RensBloom/LuxSenz/graphs section 2/lcd_shutter_and_reflective_surface_diagram.pptx

TRANSMITTER

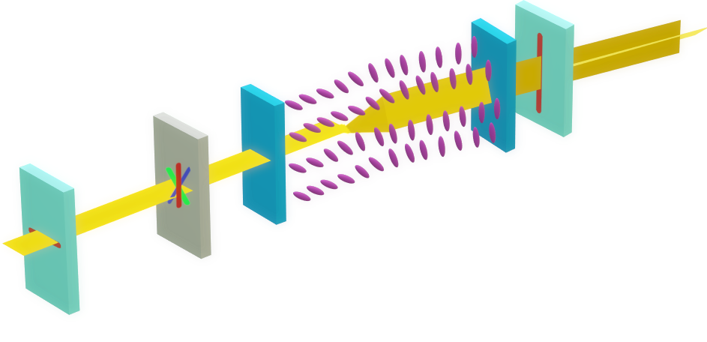
[picture p7: figure]

Polarizer films (with orthogonal axes)

Unpolarized light

RECEIVER

Phone

Liquid crystal layer

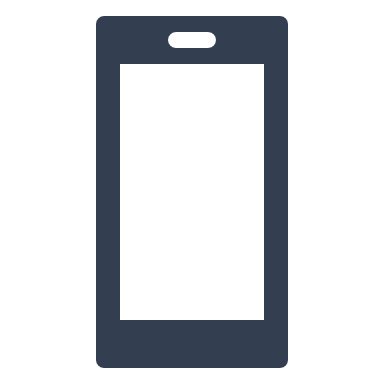
[picture p8: figure]
Smart Phone

Glass substrate

Dispersor

## Slide 2

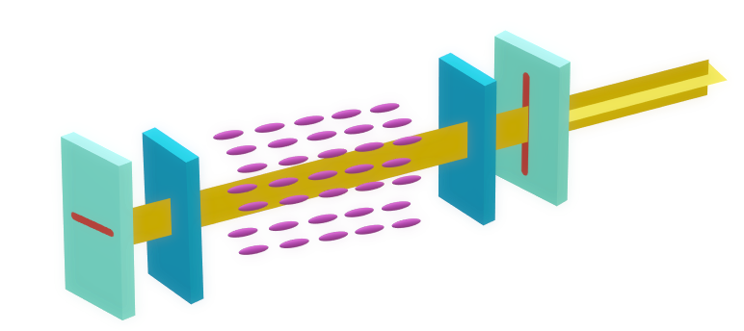
[picture p9: figure]

Voltage applied

Unpolarized light

Liquid crystal layer

Glass substrate

Polarizer films (vertical axis)

Polarizer films (horizontal axis)

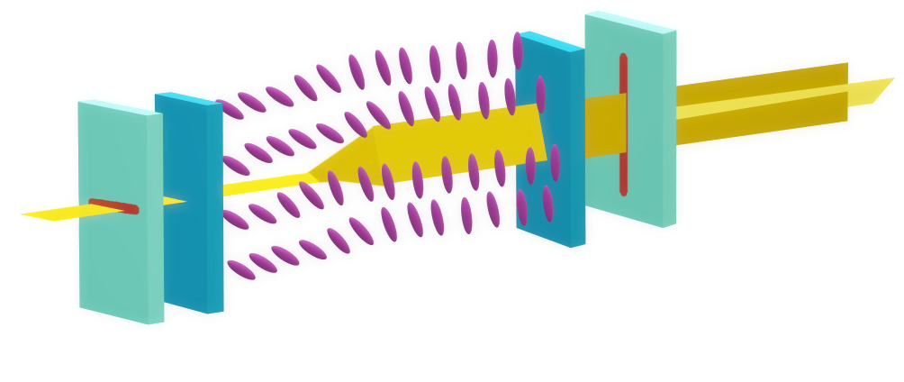
[picture p10: figure]

No voltage applied

Unpolarized light

Liquid crystal layer

## Slide 3

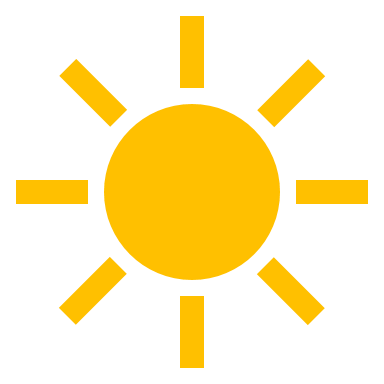
[picture p11: figure]
Sun
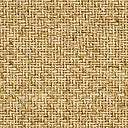
[picture p12: figure]

Mirror

Retroreflector

Diffuser
