RensBloom/LuxSenz/presentations/ES Group meeting.pptx

Light communication for sensors

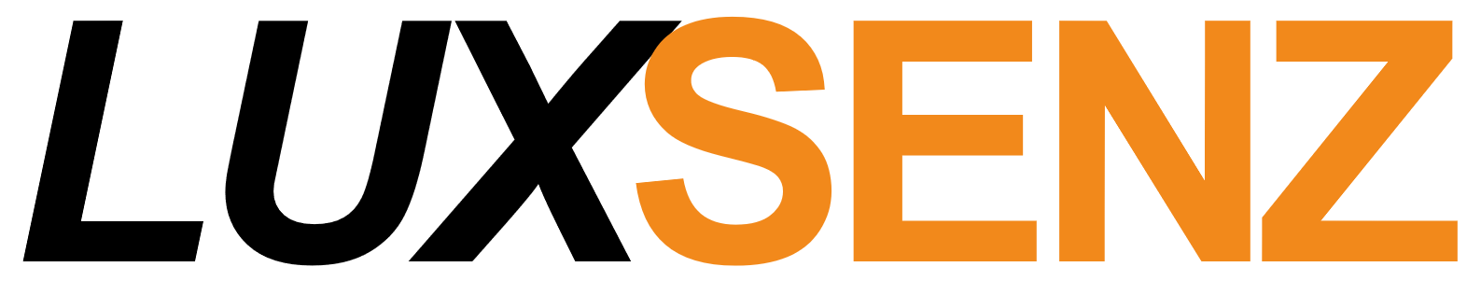
[picture p13: figure]

## The future: smart cities

Sensors everywhere

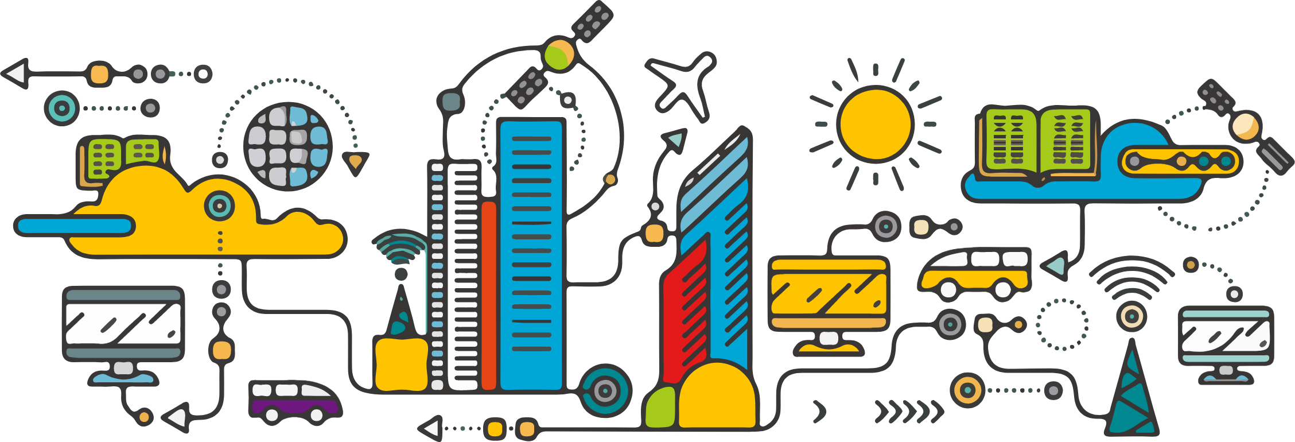
[picture p14: figure]

Notes: Let’s take a look into the future: We see smart cities in which connectivity of devices grows.
There are sensors everywhere and that is a good thing. Sensors can help monitoring the quality of life within the city. You can think of sensors to measure air pollution, traffic flows and temperature changes.

## The future: smart cities

Challenge: communication

Notes: Challenge: communication
Communication is expensive: In 2013 we were already using more energy to move bits and bytes on the Internet, than by flying airplanes over the whole world. Wireless communication like 4G, Bluetooth or WiFi always consumes a lot of energy. Adding more of those signals is a waste of energy, and present signals can degrade the communication quality and speed.

## The future: smart cities

LiFi: use the lights

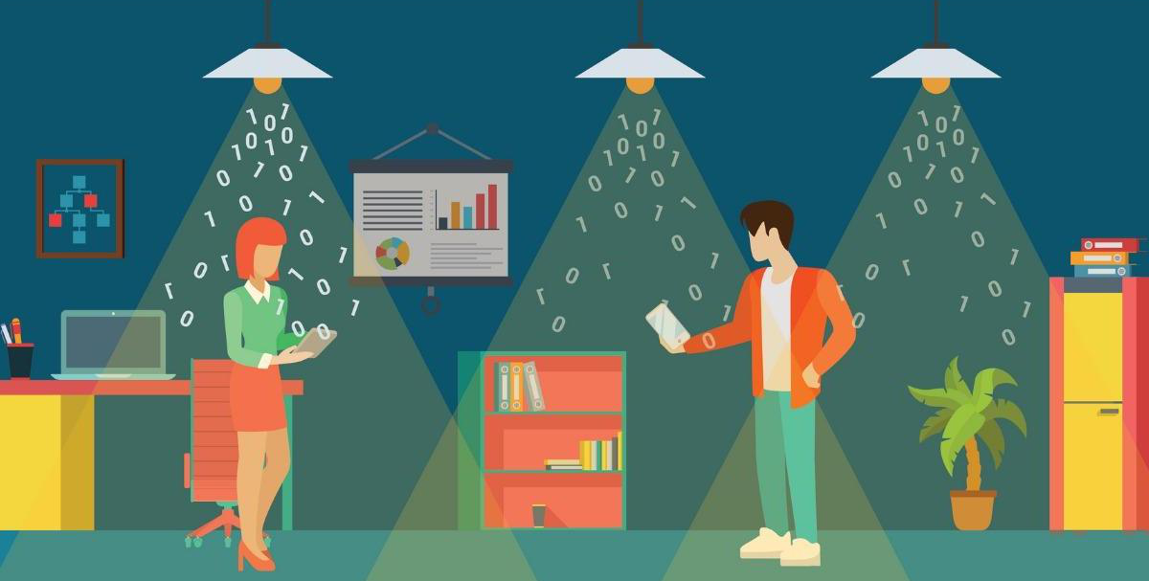
[picture p15: figure]
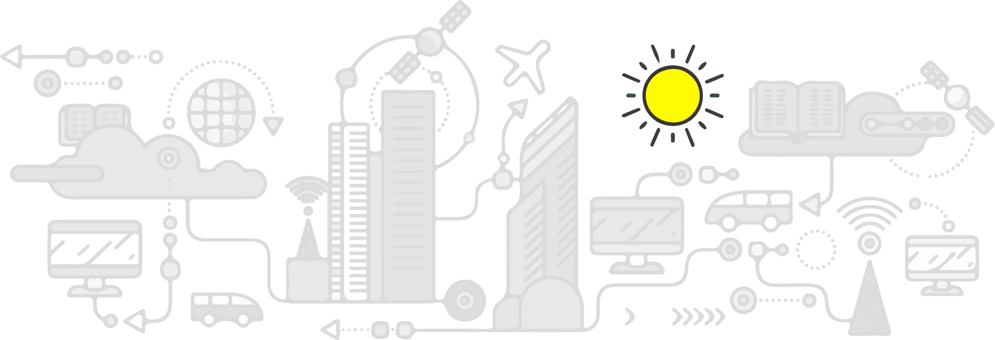
[picture p16: figure]

Notes: One solution (if the challenge is a problem), would be LiFi.
I don’t think we always want to turn on lights at daytime to enable WiFi. That would be a larger waste of energy than using WiFi.

## The future: smart cities

LuxSenz focuses on sunlight

Notes: In this city, we focus on sunlight.
The sun is an abundant resources that provides energy.
We use the energy of the sun for communication.
Natural soure of energy
We do not only use solar panels, but make light the motor/carrier of the wireless communication.
We do not need radio waves

## The future: smart cities

Reflecting the light = data

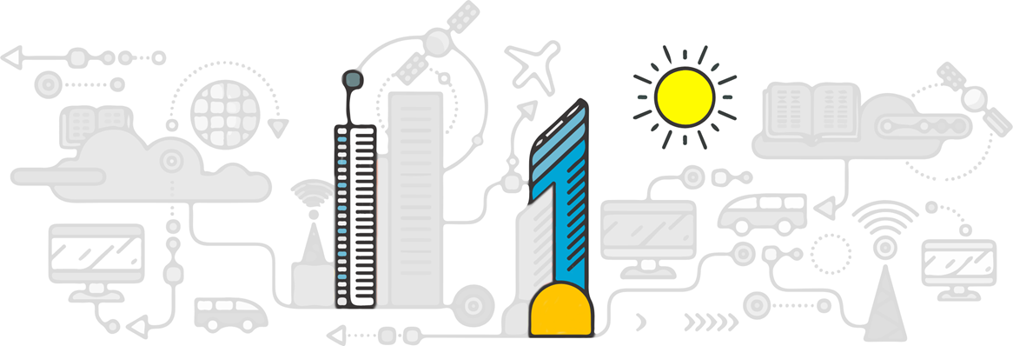
[picture p17: figure]

Notes: How does it work?
Every object reflects light. If I would were a blue or a white shirt, that already makes a difference.
By controlling reflections digitally, we can transmit sensor data directly.
Data from sensors on different buildings can be collected with minimal energy: only the collection point then needs internet.

## Demo time!

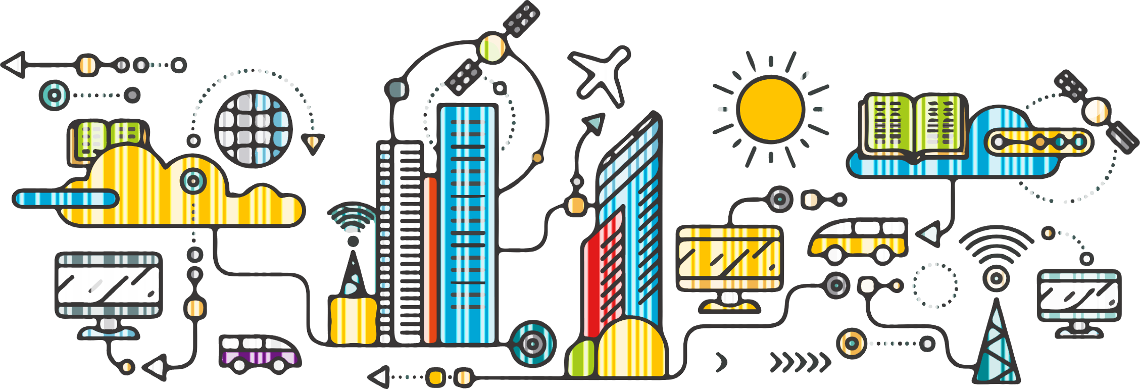
[picture p18: figure]

Notes: A vision could be to have everything in a city communication through visible light reflections.
The idea to use LuxSenz is hard to sell, but the technology works.

## The present: connecting cities

Automation is going on

Notes: Let’s go back to the city as it is now. More and more processes are automated by installing sensors and that is definitely an improvement.
We should look for urban challenges that need a bit of innovation to be solved: as a university we can offer innovative projects.

## The present: defect street lights

Usually everything works fine…

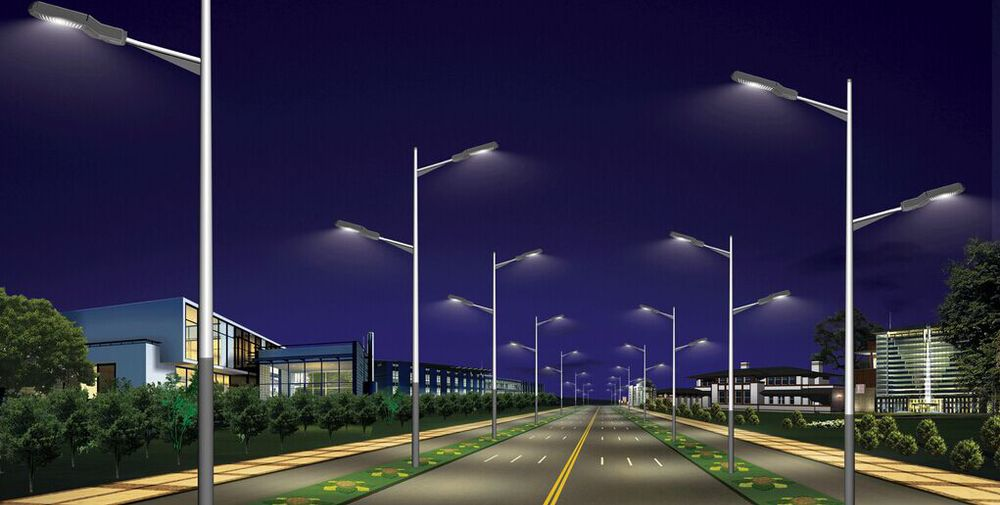
[picture p19: figure]

Notes: Let’s go back to the city as it is now

## The present: defect street lights

How would you detect a defect light?

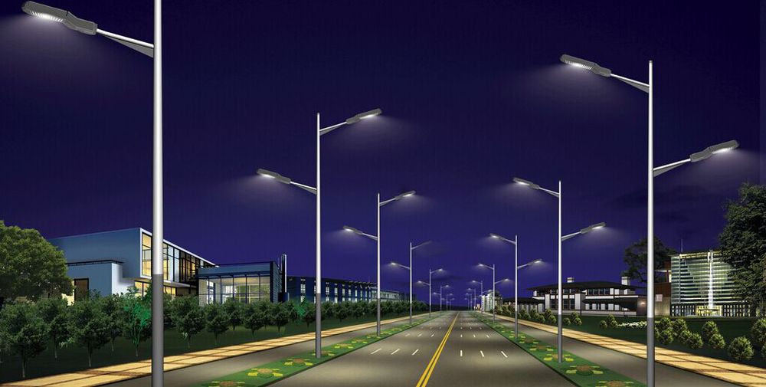
[picture p20: figure]

Notes: Let’s go back to the city as it is now
