RensBloom/LuxSenz/presentations/LuxSenz-short.pptx

Light communication for sensors


## The future: smart cities

Sensors everywhere


Notes: Let’s take a look into the future: We see smart cities in which connectivity of devices grows.
There are sensors everywhere and that is a good thing. Sensors can help monitoring the quality of life within the city. You can think of sensors to measure air pollution, traffic flows and temperature changes.

## The future: smart cities

Challenge: communication

Notes: Challenge: communication
Communication is expensive: In 2013 we were already using more energy to move bits and bytes on the Internet, than by flying airplanes over the whole world. Wireless communication like 4G, Bluetooth or WiFi always consumes a lot of energy. Adding more of those signals is a waste of energy, and present signals can degrade the communication quality and speed.

## The future: smart cities

Focus on sunlight


Notes: In this city, we focus on sunlight.
The sun is an abundant resources that provides energy.
We use the energy of the sun for communication.
Natural source of energy
We do not only use solar panels, but make light the motor/carrier of the wireless communication.
We do not need radio waves

## The future: smart cities

Works with clouds, and indoors

Notes: Using mirrors, one could build a heliograph to transmit data: similar to what armies already were using a few ages ago.
LuxSenz is designed more general, such that it works with any common source of ambient light, even with diffuse light.
It works with clouds, or indoors with LED, fluorescent and other lights.

## The future: smart cities

Reflecting the light = data


Notes: How does it work?
Every object reflects light. If I would were a blue or a white shirt, that already makes a difference.
By controlling reflections digitally, we can transmit sensor data directly.
Data from sensors on different buildings can be collected with minimal energy: only the collection point then needs internet.

## The future: smart cities

FSK signal around 600 Hz: invisible

Notes: The encoding scheme on the surface is FSK. The amount of reflected light changes a few hundred times per second such that the human eye doesn’t perceive any flickering.

## Our vision? LuxSenz everywhere


Notes: Make it ready for a large connected city, such that the sunlight is not wasted.
