RensBloom/LuxSenz/documentation/img_misc/expansion_3d_1.png

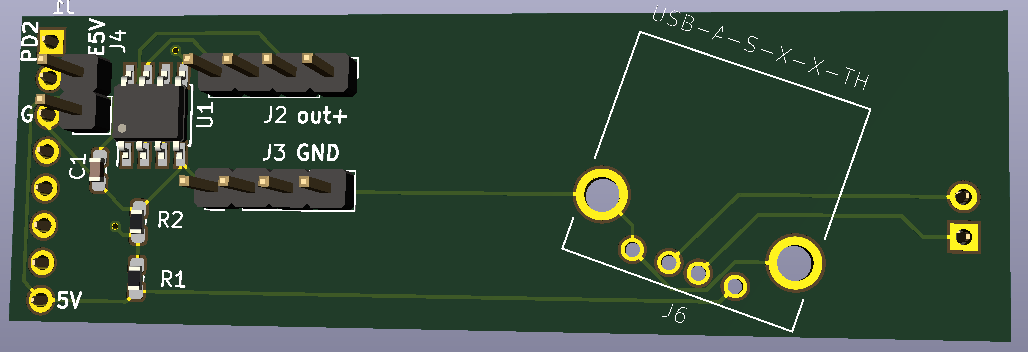
documentation/img_misc/expansion_3d_1.png
