RensBloom/LuxSenz/documentation/img_misc/expansion_3d_2.png

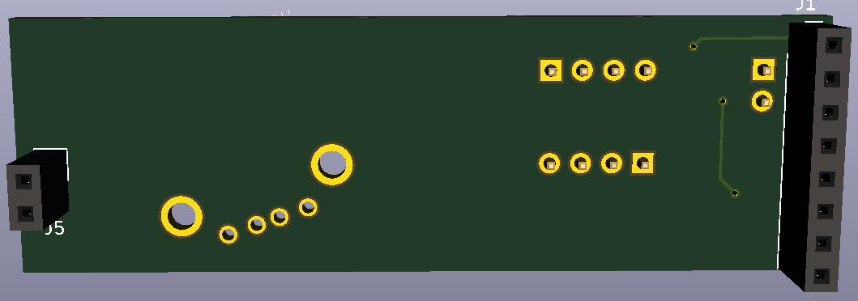
documentation/img_misc/expansion_3d_2.png
