RensBloom/LuxSenz/documentation/img_misc/headers.png

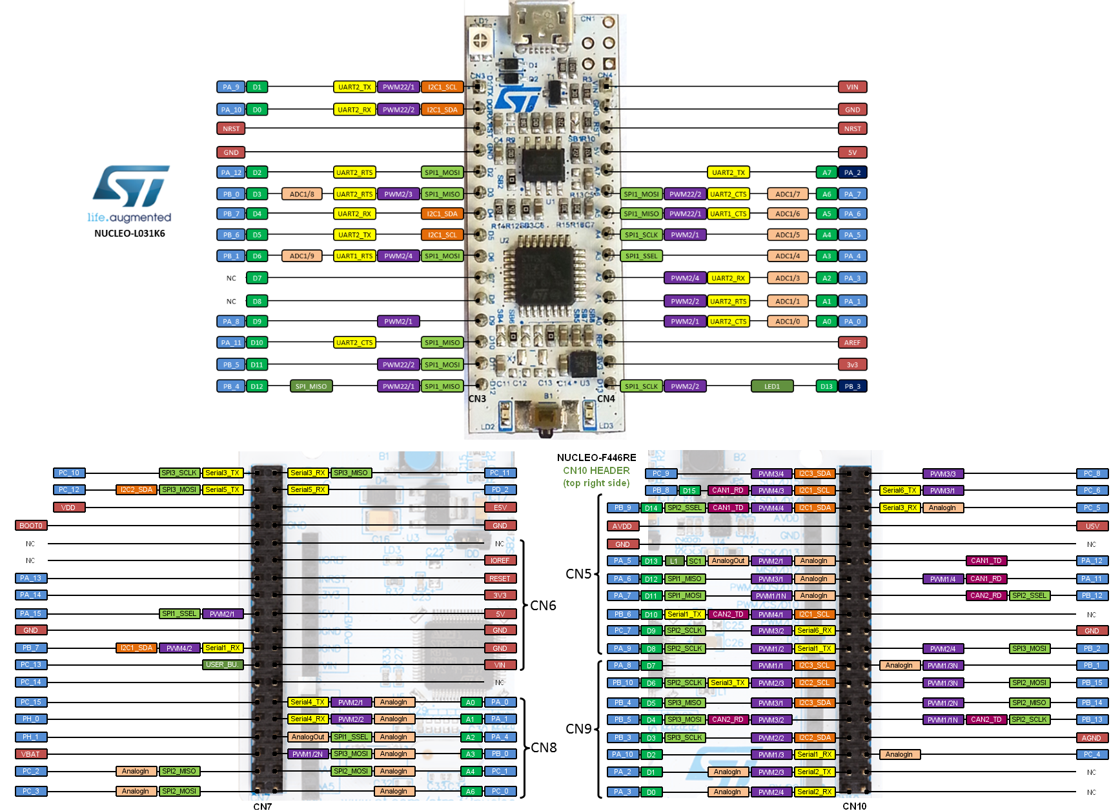
documentation/img_misc/headers.png
