RensBloom/LuxSenz/images/IMG_9840small.jpg

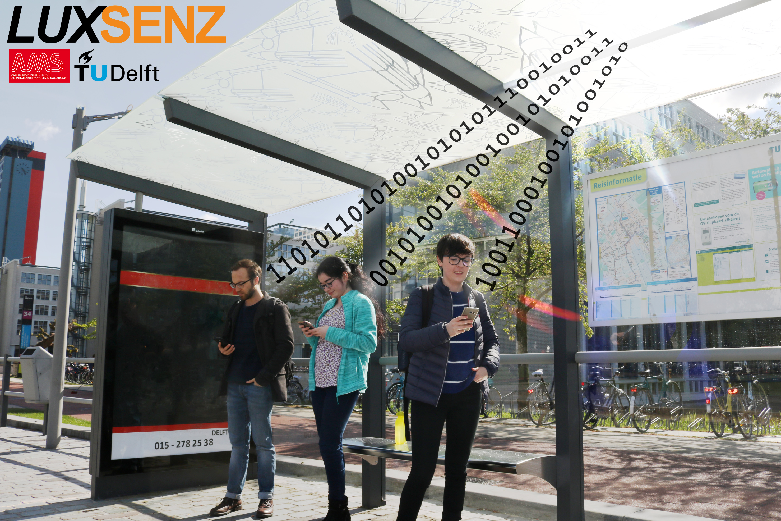
images/IMG_9840small.jpg
