RensBloom/LuxSenz/images/receiver.jpg

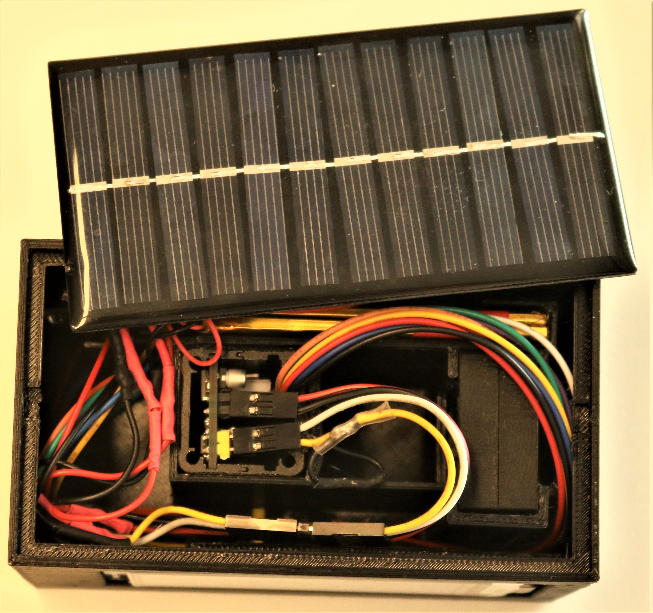
images/receiver.jpg
