RensBloom/LuxSenz/images/receiver_small3.jpg

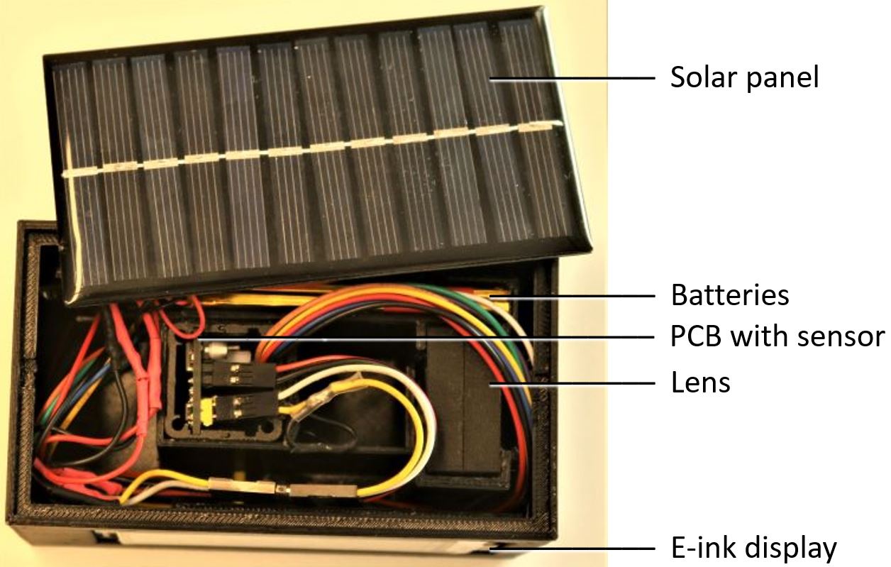
images/receiver_small3.jpg
