RensBloom/LuxSenz/images/transmitter.jpg

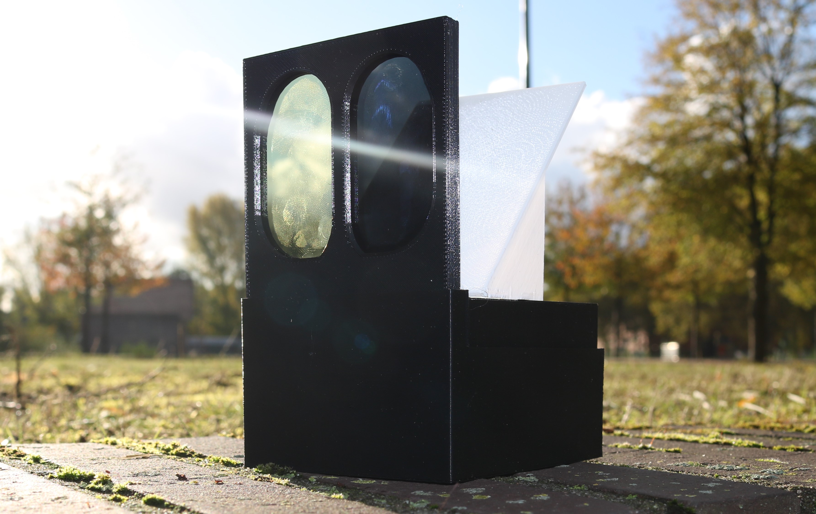
images/transmitter.jpg
