RensBloom/LuxSenz/miscellanous/luxsenz_inventory.xlsx

Sheet: Products received in Dec 2017
Serial number | Product name | Link | Dimensions | Quantity
1 | Liquid crystal light valve (LCD shutter) | https://www.sossolutions.nl/3330-liquid-crystal-light-valve-lcd-controllable-black-out-panel | 96.5 x 38 x 2mm | 15
2 | Circular TN shutter | email liquid crystal technologies for order | 110mm diameter | 2
3 | Self adhesive smart glass (5w/m2) | email oypdlc for order | a4 | 2
4 | Relay circuit | https://nl.aliexpress.com/item/Free-Shipping-1-Channel-H-L-Level-Triger-Optocoupler-Relay-New-Module-for-Arduino-12V-Smart/32658267283.html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 |  | 6
5 | Mirror | http://www.ikea.com/nl/nl/catalog/products/50366921/?query=LOTS+Mirror | 30cm*30cm | 1
6 | Solar panel 5v | https://nl.aliexpress.com/item/Solar-Cell-5V-1-25W-Portable-Module-DIY-110x69mm-Small-Solar-Panel-for-Cellular-Phone-Charger/32820292775.html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 |  | 10
7 | Solar panel 12v | https://nl.aliexpress.com/item/Universal-12V-1-5W-Standard-Epoxy-Solar-Panels-Mini-Solar-Cells-Polycrystalline-Silicon-DIY-Battery-Power/32757562057.html |  | 4
8 | Lithium battery charging module | https://nl.aliexpress.com/item/5PCS-Micro-USB-5V-1A-18650-Lithium-Battery-Charger-Board-With-Protection-Module/32666559864.html | 5 pieces per pack | 4
9 | Li ion battery 3.7v 500mah | https://nl.aliexpress.com/item/10-pcs-3-7V-500mAh-rechargeable-lipo-battery-601452-li-polymer-lithium-for-MP3-bluetooth-speaker/32819786913.html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 | pack of 10 | 1
10 | Power booster | https://nl.aliexpress.com/item/5-pcs-DC-DC-Converter-Step-Up-Boost-Module-0-9-5V-T0-5V-600MA-USB/1879190967.html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 | 5 pieces per pack | 4
11 | Logic converter | https://www.sossolutions.nl/757-4-channel-i2c-safe-bi-directional-logic-level-converter |  | 5
12 | Photo transistor | http://nl.farnell.com/osram/sfh206k/photodiode/dp/1212741?ost=sfh206k&iscrfnonsku=false |  | 30
13 | Digital light sensor | https://www.sossolutions.nl/439-adafruit-tsl2561-digital-luminosityluxlight-sensor-breakout |  | 2
14 | LCD 16x2 | https://nl.aliexpress.com/item/Free-Shipping-1PCS-LCD1602-1602-module-Green-screen-16x2-Character-LCD-Display-Module-HD44780-Controller-blue/32292861233.html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 | 2 arrived | 4

Sheet: Inventory dec 2018
 | Paid by AMS |  |  |  | Paid by TU Delft
Sr. no. | Product name | Quantity | The components are inclusive of what is installed the current LuxSenz setup | Sr. no. | Product name | Quantity
1 | Rectangular shutter | 15 | Not used in current LuxSenz setup | 51 | Nucleo F446RE MCU dev boards | 3
2 | Video shutter | 24 |  | 52 | Nucleo 031K6 dev boards | 2
3 | 3D glasses (2 shutters per glass) | 10
4 | Circular shutter | 1
5 | Pi cell | 50
6 | Smart glass | 2
7 | Luxsenz transmitter F446RE extension PCB | 4
8 | Luxsenz receiver PCB | 40 | Many of these are not yet assembled
9 | Luxsenz transceiver PCB | 40 | Many of these are not yet assembled
10 | Luxmeter | 2
11 | Solar panel 6V (110*60 mm) | 4
12 | E ink display | 2
13 | LiPo battery 3.7V | 3
14 | ST LINK V2 STM32 programmer | 0 | Nucleo development boards can also be used as a programmer. Otherwise, buy one of these on Ebay (less than $3)
15 | 25mm diameter lens | 5
16 | Other lenses | 3
17 | TP4056 Li battery charger | 7
18 | MPL115A2 sensor (pressure)
19 | Si7021 (temp/humidity)
20 | Transmitter 3D print | 4
21 | Receiver 3D print | 4
22 | Transceiver 3D print | 1
23 | STM32LO31K6T6 LQFP-32 | 1
24 | Logic converter (CJMCU 0108) | 5
25 | CD4049UBE inverter IC | 2
26 | CD4070BE XOR IC | 1
27 | LM324AN OPAMP IC | 1
28 | Mirror 30*30 cm | 4
30 | DC to DC converter (step up booster to 5 V) | 20
31 | optocoupler relay (for smart glass) | 6
32 | LCD 16X2 | 2
33 | Mirrors square (for video shutter) | 4
34 | Mirrors rect (for rect shutter) | 3
35 | Mirrors circ (for circ shutter) | 2
36 | 8-pin JST-XH Cables | 6
37 | 4-pin Dupont jumber wires | >5
38 | STM32F103C8T6 dev boards | 76
39 | HC SR04 ultrasone sensor | 2
