RensBloom/LuxSenz/miscellanous/LuxSenz performance.xlsx

Sheet: Sheet1
 |  |  |  |  |  |  |  | Battery voltage | Light intensity (lx) |  |  |  | Transmitter | BER |  | Notes
FSK f1 | FSK f2 | Duty Cycle (%) | Balanced? | Transmitter | Receiver | Location | Surface (cm2) | Transmitter | Transmitter | Receiver | Distance (cm) | Angle (deg) | offset (cm) | error | total
560 | 640 | 50 | no | L031K6 + 2x 3D glass shutter | Purple/white | Social Data Lab | 26 | 4.4 | 190 | 78 | 177 | 0 |  | 1 | 10000 | Light intensity without LEDs turned on: 18lx, 25lx
560 | 640 | 50 | no | L031K6 + 2x 3D glass shutter | Purple/white | Social Data Lab | 26 | 4.4 | 190 | 100 | 245 | 0 |  | 0 | 10000
560 | 640 | 50 | no | L031K6 + 2x 3D glass shutter | Purple/white | Social Data Lab | 26 | 4.4 | 190 | 80 | 308 | 0 |  | 0 | 10000
560 | 640 | 50 | no | L031K6 + 2x 3D glass shutter | Purple/white | Social Data Lab | 26 | 4.4 | 200 | 80 | 614 | 0 |  | 0 | 10000
560 | 640 | 50 | no | L031K6 + 2x 3D glass shutter | Purple/white | Social Data Lab | 26 | 4.4 | 220 | 45 | 727 | 0 |  | 5 | 10000
560 | 640 | 50 | no | L031K6 + 2x 3D glass shutter | Purple/white | Social Data Lab | 26 | 4.4 | 220 | 50 | 750 | 0 |  | 8 | 10000
560 | 640 | 50 | no | L031K6 + 2x 3D glass shutter | Purple/white | Social Data Lab | 26 | 4.4 | 200 | 45 | 775 | 0 |  | 11 | 10000
560 | 640 | 50 | no | L031K6 + 2x 3D glass shutter | Purple/white | Social Data Lab | 26 | 4.4 | 240 | 50 | 800 | 0 | 0 | 46 | 10000
560 | 640 | 50 | no | L031K6 + 2x 3D glass shutter | Purple/white | Social Data Lab | 26 | 4.4 | 240 | 45 | 800 | 0 | 1 | 36 | 10000
560 | 640 | 50 | no | L031K6 + 2x 3D glass shutter | Purple/white | Social Data Lab | 26 | 4.4 | 240 | 45 | 800 | 0 | 2 | 34 | 10000
560 | 640 | 50 | no | L031K6 + 2x 3D glass shutter | Purple/white | Social Data Lab | 26 | 4.4 | 220 | 50 | 800 | 0 | 3 | 30 | 10000
560 | 640 | 50 | no | L031K6 + 2x 3D glass shutter | Purple/white | Social Data Lab | 26 | 4.4 | 220 | 50 | 800 | 0 | 4 | 61 | 10000
560 | 640 | 50 | no | L031K6 + 2x 3D glass shutter | Purple/white | Social Data Lab | 26 | 4.4 | 220 | 50 | 800 | 0 | 5 | 36 | 5000
560 | 640 | 50 | no | L031K6 + 2x 3D glass shutter | Purple/white | Social Data Lab | 26 | 4.4 | 220 | 50 | 800 | 0 | -0.5 | 102 | 7000
560 | 640 | 50 | no | L031K6 + 2x 3D glass shutter | Purple/white | Social Data Lab | 26 | 4.4 | 220 | 50 | 800 | 0 | 0.5 | 96 | 10000
560 | 640 | 50 | no | L031K6 + 2x 3D glass shutter | Purple/white | Social Data Lab | 26 | 4.4 | 220 | 50 | 800 | -20 | 0 | 60 | 720
560 | 640 | 50 | no | L031K6 + 2x 3D glass shutter | Purple/white | Social Data Lab | 26 | 4.4 | 220 | 50 | 800 | -10 | 0 | 101 | 1200
560 | 640 | 50 | no | L031K6 + 2x 3D glass shutter | Purple/white | Social Data Lab | 26 | 4.4 | 220 | 50 | 800 | -5 | 0 | 50 | 2000
560 | 640 | 50 | no | L031K6 + 2x 3D glass shutter | Purple/white | Social Data Lab | 26 | 4.4 | 220 | 50 | 800 | 0 | 0 | 60 | 3100
560 | 640 | 50 | no | L031K6 + 2x 3D glass shutter | Purple/white | Social Data Lab | 26 | 4.4 | 220 | 50 | 800 | 5 | 0 | 72 | 2800
560 | 640 | 50 | no | L031K6 + 2x 3D glass shutter | Purple/white | Social Data Lab | 26 | 4.4 | 220 | 50 | 800 | 10 | 0 | 48 | 1072
560 | 640 | 50 | no | L031K6 + 2x 3D glass shutter | Purple/white | Social Data Lab | 26 | 4.4 | 290 | 120 | 615 | 0 | 0 | 2 | 10000
560 | 640 | 50 | no | L031K6 + 2x 3D glass shutter | Purple/white | Social Data Lab | 26 | 4.4 | ? | ? | 615 | 15 | 0 | 1 | 10000
560 | 640 | 50 | no | L031K6 + 2x 3D glass shutter | Purple/white | Social Data Lab | 26 | 4.4 | ? | ? | 615 | 30 | 0 | 12 | 10000
560 | 640 | 50 | no | L031K6 + 2x 3D glass shutter | Purple/white | Social Data Lab | 26 | 4.4 | ? | ? | 615 | 45 | 0 | 72 | 592
560 | 640 | 50 | no | L031K6 + 2x 3D glass shutter | Purple/white | Social Data Lab | 26 | 4.4 | 200 | 100 | 615 | 37.5 | 0 | 46 | 10000
560 | 640 | 50 | no | L031K6 + 2x 3D glass shutter | Yellow/Black | Social Data Lab | 26 | 4.35 | 260 | 120 | 615 | 0 | 0 | 20 | 10000
560 | 640 | 50 | no | L031K6 + 2x 3D glass shutter | Yellow/Black | Social Data Lab | 26 | 5.03 | 380 | 190 | 615 | 0 | 0 | 5 | 10000
560 | 640 | 50 | no | L031K6 + 2x 3D glass shutter | Yellow/Black | Social Data Lab | 26 | 5.03 | 410-470 | 190-200 | 615 |  |  | 9 | 10000
560 | 640 | 50 | no | L031K6 + 2x 3D glass shutter | Yellow/Black | Social Data Lab | 26 | 5.03 | 130-150 | 80 | 615 |  |  | 40 | 5000
560 | 640 | 50 | no | L031K6 + 2x 3D glass shutter | Yellow/Black | Social Data Lab | 26 | 5.03 | 100 | 60 | 615 |  |  | 37 | 3700
560 | 640 | 50 | no | L031K6 + 2x 3D glass shutter | Yellow/Black | Social Data Lab | 26 | 5.03 | 50 | 70 | 615 |  |  | 15 | 400
560 | 640 | 50 | no | L031K6 + 2x 3D glass shutter | Yellow/Black | Social Data Lab | 26 | 5.03 | 70 | 90 | 615 |  |  | 18 | 1500
560 | 640 | 50 | no | L031K6 + 2x 3D glass shutter | Yellow/Black | Social Data Lab | 26 | 5.03 | 260 | 140 | 616 |  |  | 8 | 10000
560 | 640 | 50 | no | L031K6 + 2x 3D glass shutter | Yellow/Black | Outdoors (Cloudy) | 26 | 5 | 33000 | sat (+- 60000) | 1750 |  |  | 23 | 10000
560 | 640 | 50 | no | L031K6 + 2x 3D glass shutter | Yellow/Black | Outdoors (Cloudy) | 26 | 4.35 | 33000 | sat (+- 60000) | 1750 |  |  | 2 | 10000
560 | 640 | 50 | no | L031K6 + 2x 3D glass shutter | Yellow/Black | Outdoors (Cloudy) | 26 | 4.35 | 37000 |  | 2400 |  |  | 41 | 10000
560 | 640 | 50 | no | L031K6 + 2x 3D glass shutter | Yellow/Black | Outdoors (Cloudy) | 26
560 | 640 | 50 | no | L031K6 + 2x 3D glass shutter | Yellow/Black | Outdoors (Cloudy) | 26
560 | 640 | 50 | no | L031K6 + 2x 3D glass shutter | Yellow/Black | Outdoors (Cloudy) | 26
560 | 640 | 50 | no | L031K6 + 2x 3D glass shutter | Yellow/Black | Outdoors (Cloudy) | 26

Sheet: Sheet 2
 |  |  |  |  |  |  | Transmitter |  |  |  |  |  | Battery voltage |  | Sideways | Light intensity (lx) |  | Light intensity (lx) |  | BER |  |  | PLR |  |  | amplitude |  |  | nothing |  | amp |  | coverage
id | set | FSK f1 | FSK f2 | Duty Cycle (%) | Balanced? | Receiver | MCU | Surface | f | Location | Location | Surface (cm2) | Transmitter | Distance (m) | offset (cm) | Receiver | Transmitter | Receiver | Transmitter | error | total | BER | error | total | PLR | S1 | S2 | P3 | S1 | S1/lx_t | S1 delta | S1d/lx_t | X (cm) | Y (cm) | X (m) | Y (m) | lux sets | BSR | PSR
1 | 1 | 560 | 640 | 50 | yes | Yellow/Black | L031K6 | 2x 3D glass shutter | 560/640 | Basement | 1 | 26 | 4.4 | 1 | 0 | 200 | 300 | 200 | 300 | 78 | 10000 | 0.007800 | 10 | 35 | 0.286 |  |  |  |  |  |  |  |  |  |  |  | 1 | 0.9922 | 0.7142857143
2 | 1 | 560 | 640 | 50 | yes | Yellow/Black | L031K6 | 2x 3D glass shutter | 560/640 | Basement | 1 | 26 | 4.4 | 2 | 0 | 200 | 210 | 200 | 210 | 41 | 480 | 0.085417 | inf | 0 | 1.000 |  |  |  |  |  |  |  |  |  |  |  | 1 | 0.9145833333 | 0
3 | 1 | 560 | 640 | 50 | yes | Yellow/Black | L031K6 | 2x 3D glass shutter | 560/640 | Basement | 1 | 26 | 4.4 | 3 | 0 | 200 | 400 | 200 | 400 |  |  |  |  |  |  |  |  |  |  |  |  |  |  |  |  |  | 2
4 | 2 | 560 | 640 | 50 | yes | Yellow/Black | L031K6 | 2x 3D glass shutter | 560/640 | Outdoors | 2 | 26 | 4.4 | 5 | 0 | 6000 | 6000 | 6000 | 6000 | 9 | 10000 | 0.000900 | 3 | 36 | 0.083 | 4094 | 4094 | 16000 |  | 0.6823333333 |  |  |  |  |  |  | 3 | 0.9991 | 0.9166666667
5 | 2 | 560 | 640 | 50 | yes | Yellow/Black | L031K6 | 2x 3D glass shutter | 560/640 | Outdoors | 2 | 26 | 4.4 | 10 | 0 | 5700 | 11000 | 5700 | 11000 | 33 | 10000 | 0.003300 | 9 | 35 | 0.257 | 3700 | 3800 | 12300 |  | 0.3363636364 |  |  |  |  |  |  | 4 | 0.9967 | 0.7428571429
6 | 2 | 560 | 640 | 50 | yes | Yellow/Black | L031K6 | 2x 3D glass shutter | 560/640 | Outdoors | 2 | 26 | 4.4 | 15 | 0 | 6000 | 10000 | 6000 | 10000 | 1 | 10000 | 0.000100 | 0 | 37 | 0.000 | 2000 | 2200 | 5500 |  | 0.2 |  |  |  |  |  |  | 4 | 0.9999 | 1
7 | 2 | 560 | 640 | 50 | yes | Yellow/Black | L031K6 | 2x 3D glass shutter | 560/640 | Outdoors | 2 | 26 | 4.4 | 20 | 0 | 7000 | 13000 | 7000 | 13000 | 1 | 10000 | 0.000100 | 0 | 36 | 0.000 | 1400 | 1500 | 3500 |  | 0.1076923077 |  |  |  |  |  |  | 4 | 0.9999 | 1
8 | 2 | 560 | 640 | 50 | yes | Yellow/Black | L031K6 | 2x 3D glass shutter | 560/640 | Outdoors | 2 | 26 | 4.4 | 25 | 0 | 9000 | 12000 | 9000 | 12000 | 0 | 10000 | 0.000000 | 0 | 36 | 0.000 | 800 | 1000 | 2000 |  | 0.06666666667 |  |  |  |  |  |  | 4 | 1 | 1
9 | 2 | 560 | 640 | 50 | yes | Yellow/Black | L031K6 | 2x 3D glass shutter | 560/640 | Outdoors | 2 | 26 | 4.4 | 30 | 0 | 9000 | 10000 | 9000 | 10000 | 5 | 14000 | 0.000357 | 3 | 50 | 0.060 | 600 | 700 | 1200 |  | 0.06 |  |  |  |  |  |  | 4 | 0.9996428571 | 0.94
10 | 2 | 560 | 640 | 50 | yes | Yellow/Black | L031K6 | 2x 3D glass shutter | 560/640 | Outdoors | 2 | 26 | 4.4 | 35 | 0 | 9000 | 9000 | 9000 | 9000 | 63 | 10000 | 0.006300 | 7 | 36 | 0.194 | 500 | 650 | 800 |  | 0.05555555556 |  |  |  |  |  |  | 3 | 0.9937 | 0.8055555556
11 | 2 | 560 | 640 | 50 | yes | Yellow/Black | L031K6 | 2x 3D glass shutter | 560/640 | Outdoors | 2 | 26 | 4.4 | 40 | 0 | 11000 | 10000 | 11000 | 10000 | 54 | 5000 | 0.010800 | 3 | 11 | 0.273 | 450 | 670 | 725 |  | 0.045 |  |  |  |  |  |  | 4 | 0.9892 | 0.7272727273
12 | 2 | 560 | 640 | 50 | yes | Yellow/Black | L031K6 | 2x 3D glass shutter | 560/640 | Outdoors | 2 | 26 | 4.4 | 45 | 0 | 14k | 13k | 14000 | 13000 | 42 | 9000 | 0.004667 | 8 | 31 | 0.258 | 502 | 699 | 863 |  | 0.03861538462 |  |  |  |  |  |  | 4 | 0.9953333333 | 0.7419354839
13 | 2 | 560 | 640 | 50 | yes | Yellow/Black | L031K6 | 2x 3D glass shutter | 560/640 | Outdoors | 2 | 26 | 4.4 | 50 | 0 | 17k | 13k | 17000 | 13000 | 30 | 1300 | 0.023077 | 3 | 6 | 0.500 | 400 | 550 | 520 |  | 0.03076923077 |  |  |  |  |  |  | 4 | 0.9769230769 | 0.5
14 | 3 | 560 | 640 | 50 | yes | Yellow/Black | L031K6 | 2x 3D glass shutter | 560/640 | Outdoors | 2 | 26 | 4.4 | 10 | 30 | 30k | 11k | 30000 | 11000 | inf | 0 | 1.000000 | inf | 0 | 1.000 | 300 | 500 | 280 |  | 0.02727272727 |  |  |  |  |  |  | 0 | 0 | 0
15 | 3 | 560 | 640 | 50 | yes | Yellow/Black | L031K6 | 2x 3D glass shutter | 560/640 | Outdoors | 2 | 26 | 4.4 | 15 | 30 | 22k | 9000 | 22000 | 9000 | 45 | 400 | 0.112500 | 1 | 1 | 1.000 | 300 | 500 | 300 |  | 0.03333333333 |  |  |  |  |  |  | 0 | 0.8875 | 0
16 | 3 | 560 | 640 | 50 | yes | Yellow/Black | L031K6 | 2x 3D glass shutter | 560/640 | Outdoors | 2 | 26 | 4.4 | 20 | 30 | 28k | 9500 | 28000 | 9500 | 21 | 4500 | 0.004667 | 9 | 18 | 0.500 | 500 | 650 | 1100 |  | 0.05263157895 |  |  |  |  |  |  | 0 | 0.9953333333 | 0.5
17 | 3 | 560 | 640 | 50 | yes | Yellow/Black | L031K6 | 2x 3D glass shutter | 560/640 | Outdoors | 2 | 26 | 4.4 | 25 | 30 | 18k | 12k | 18000 | 12000 | 15 | 10000 | 0.001500 | 2 | 37 | 0.054 | 600 | 800 | 1200 |  | 0.05 |  |  |  |  |  |  | 0 | 0.9985 | 0.9459459459
18 | 3 | 560 | 640 | 50 | yes | Yellow/Black | L031K6 | 2x 3D glass shutter | 560/640 | Outdoors | 2 | 26 | 4.4 | 30 | 30 | 20k | 13k | 20000 | 13000 | 20 | 10000 | 0.002000 | 3 | 37 | 0.081 | 650 | 800 | 1200 |  | 0.05 |  |  |  |  |  |  | 0 | 0.998 | 0.9189189189
19 | 3 | 560 | 640 | 50 | yes | Yellow/Black | L031K6 | 2x 3D glass shutter | 560/640 | Outdoors | 2 | 26 | 4.4 | 35 | 30 | 27k | 22k | 27000 | 22000 | 21 | 10000 | 0.002100 | 6 | 35 | 0.171 | 580 | 700 | 800 |  | 0.02636363636 |  |  |  |  |  |  | 0 | 0.9979 | 0.8285714286
20 | 3 | 560 | 640 | 50 | yes | Yellow/Black | L031K6 | 2x 3D glass shutter | 560/640 | Outdoors | 2 | 26 | 4.4 | 40 | 30 | 22k | 13k | 22000 | 13000 | 11 | 1100 | 0.010000 | 3 | 5 | 0.600 | 500 | 600 | 550 |  | 0.03846153846 |  |  |  |  |  |  | 0 | 0.99 | 0.4
21 | 4 | 560 | 640 | 50 | yes | Yellow/Black | L031K6 | 2x 3D glass shutter | 560/640 | Outdoors | 2 | 26 | 4.4 | 15 | 60 |  |  | ? | ? | inf | 0 | 1.000000 | inf | 0 | 1.000 |  |  |  |  |  |  |  |  |  |  |  | 0 | 0 | 0
22 | 4 | 560 | 640 | 50 | yes | Yellow/Black | L031K6 | 2x 3D glass shutter | 560/640 | Outdoors | 2 | 26 | 4.4 | 20 | 60 |  |  | ? | ? | inf | 0 | 1.000000 | inf | 0 | 1.000 |  |  |  |  |  |  |  |  |  |  |  | 0 | 0 | 0
23 | 4 | 560 | 640 | 50 | yes | Yellow/Black | L031K6 | 2x 3D glass shutter | 560/640 | Outdoors | 2 | 26 | 4.4 | 25 | 60 |  |  | ? | ? | inf | 0 | 1.000000 | inf | 0 | 1.000 |  |  |  |  |  |  |  |  |  |  |  | 0 | 0 | 0
24 | 4 | 560 | 640 | 50 | yes | Yellow/Black | L031K6 | 2x 3D glass shutter | 560/640 | Outdoors | 2 | 26 | 4.4 | 40 | 60 | 30k | 10k | 30000 | 10000 | inf |  | 1.000000 |  |  |  |  |  |  |  |  |  |  |  |  |  |  | 0 | 0
25 | 5 | 560 | 640 | 50 | yes | Yellow/Black | L031K6 | 2x 3D glass shutter | 560/640 | Outdoors | 2 | 26 | 4.4 | 40 | 45 | 20k | 9k | 20000 | 9000 | 45 | 400 | 0.112500 | 1 | 1 | 1.000 |  |  |  |  |  |  |  |  |  |  |  | 0 | 0.8875 | 0
26 | 5 | 560 | 640 | 50 | yes | Yellow/Black | L031K6 | 2x 3D glass shutter | 560/640 | Outdoors | 2 | 26 | 4.4 | 35 | 45 | 19k | 8k | 19000 | 8000 | 31 | 300 | 0.103333 | 1 | 1 | 1.000 | 400 | 540 | 400 |  | 0.05 |  |  |  |  |  |  | 0 | 0.8966666667 | 0
27 | 5 | 560 | 640 | 50 | yes | Yellow/Black | L031K6 | 2x 3D glass shutter | 560/640 | Outdoors | 2 | 26 | 4.4 | 30 | 45 | 25k | 8k | 25000 | 8000 | 45 | 450 | 0.100000 | 1 | 1 | 1.000 | 370 | 550 | 450 |  | 0.04625 |  |  |  |  |  |  | 0 | 0.9 | 0
28 | 5 | 560 | 640 | 50 | yes | Yellow/Black | L031K6 | 2x 3D glass shutter | 560/640 | Outdoors | 2 | 26 | 4.4 | 25 | 45 | 25k | 10k | 25000 | 10000 | 18 | 176 | 0.102273 | 1 | 1 | 1.000 | 350 | 450 | 200 |  | 0.035 |  |  |  |  |  |  | 0 | 0.8977272727 | 0
29 | 5 | 560 | 640 | 50 | yes | Yellow/Black | L031K6 | 2x 3D glass shutter | 560/640 | Outdoors | 2 | 26 | 4.4 | 20 | 45 | 25k | 9k | 25000 | 9000 | inf | 0 | 1.000000 | inf | 0 | 1.000 |  |  |  |  |  |  |  |  |  |  |  | 0 | 0 | 0
30 | 6 | 560 | 640 | 50 | yes | Yellow/Black | L031K6 | no shutter | 560/640 | Outdoors | 2 | 0 | 4.4 | - | - | 20k | - | 20000 | ? | - | - |  | - | - |  | 300 | 500 | 200 |  |  |  |  |  |  |  |  | 0
31 | 7 | 560 | 640 | 50 | yes | Yellow/Black | L031K6 | 2x 3D glass shutter | 625/714 | Outdoors | 2 | 26 | 4.4 | 25 | 0 | 20k | 7500 | 20000 | 7500 | 0 | 10000 | 0.000000 | 0 | 36 | 0.000 | 600 | 750 | 1100 |  | 0.08 |  |  |  |  |  |  | 3 | 1 | 1
32 | 7 | 560 | 640 | 50 | yes | Yellow/Black | L031K6 | 2x 3D glass shutter | 625/714 | Outdoors | 2 | 26 | 4.4 | 30 | 0 | 9000 | 6000 | 9000 | 6000 | 7 | 10000 | 0.000700 | 1 | 36 | 0.028 | 500 | 650 | 650 |  | 0.08333333333 |  |  |  |  |  |  | 3 | 0.9993 | 0.9722222222
33 | 7 | 560 | 640 | 50 | yes | Yellow/Black | L031K6 | 2x 3D glass shutter | 625/714 | Outdoors | 2 | 26 | 4.4 | 35 | 0 | 11k | 7000 | 11000 | 7000 | 3 | 7000 | 0.000429 | 0 | 26 | 0.000 | 450 | 550 | 500 |  | 0.06428571429 |  |  |  |  |  |  | 3 | 0.9995714286 | 1
34 | 7 | 560 | 640 | 50 | yes | Yellow/Black | L031K6 | 2x 3D glass shutter | 625/714 | Outdoors | 2 | 26 | 4.4 | 40 | 0 | 9700 | 8000 | 9700 | 8000 | 57 | 7000 | 0.008143 | 11 | 25 | 0.440 | 450 | 600 | 550 |  | 0.05625 |  |  |  |  |  |  | 3 | 0.9918571429 | 0.56
35 | 7 | 560 | 640 | 50 | yes | Yellow/Black | L031K6 | 2x 3D glass shutter | 625/714 | Outdoors | 2 | 26 | 4.4 | 45 | 0 | 15k | 9000 | 15000 | 9000 | 113 | 8000 | 0.014125 | 20 | 28 | 0.714 | 400 | 600 | 550 |  | 0.04444444444 |  |  |  |  |  |  | 3 | 0.985875 | 0.2857142857
36 | 7 | 560 | 640 | 50 | yes | Yellow/Black | L031K6 | 2x 3D glass shutter | 625/714 | Outdoors | 2 | 26 | 4.4 | 50 | 0 | 15k |  | 15000 | ? | 150 | 3528 | 0.042517 | 12 | 12 | 1.000 | 430 | 600 | 632 |  |  |  |  |  |  |  |  | 0 | 0.9574829932 | 0
37 | 8 | 560 | 640 | 50 | yes | Yellow/Black | L031K6 | 2x 3D glass shutter | 560/640 | Outdoors | 2 | 26 | 4.4 | 20 | 0 | 4200 | 7000 | 4200 | 7000 | 0 | 10000 | 0.000000 | 0 | 36 | 0.000 | 650 | 820 | 1600 |  | 0.09285714286 |  |  |  |  |  |  | 3 | 1 | 1
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
75 | 16 | 560 | 640 | 50 | yes | Yellow/Black | L031K6 | 2x 3D glass shutter | 560/640 | SDL late | 5 | 26 | 4.4 | 1.6 | 0 |  | 220 | ? | 220 | 15 | 3000 | 0.005000 | 5 | 11 | 0.455 | 101 |  |  | 52 | 0.4590909091 | 49 | 0.2227272727 |  |  |  |  | 1 | 0.995 | 0.5454545455
76 | 16 | 560 | 640 | 50 | yes | Yellow/Black | L031K6 | 2x 3D glass shutter | 560/640 | SDL late | 5 | 26 | 4.4 | 1.8 | 0 |  | 150 | ? | 150 | 37 | 1000 | 0.037000 | 2 | 2 | 1.000 | 68 |  |  | 52 | 0.4533333333 | 16 | 0.1066666667 |  |  |  |  | 1 | 0.963 | 0
77 | 16 | 560 | 640 | 50 | yes | Yellow/Black | L031K6 | 2x 3D glass shutter | 560/640 | SDL late | 5 | 26 | 4.4 | 2 | 0 |  | 210 | ? | 210 | 62 | 896 | 0.069196 | 2 | 2 | 1.000 | 67 |  |  | 52 | 0.319047619 | 15 | 0.07142857143 |  |  |  |  | 1 | 0.9308035714 | 0
78 | 16 | 560 | 640 | 50 | yes | Yellow/Black | L031K6 | 2x 3D glass shutter | 560/640 | SDL late | 5 | 26 | 4.4 | 2 | 0 | 60 | 220 | 60 | 220 | 249 | 10000 | 0.024900 | 23 | 35 | 0.657 | 73 |  |  | 52 | 0.3318181818 | 21 | 0.09545454545 |  |  |  |  | 1 | 0.9751 | 0.3428571429
79 | 16 | 560 | 640 | 50 | yes | Yellow/Black | L031K6 | 2x 3D glass shutter | 560/640 | SDL late | 5 | 26 | 4.4 | 2.2 | 0 |  | 210 | ? | 210 | 76 | 680 | 0.111765 | 2 | 2 | 1.000 | 63 |  |  | 52 | 0.3 | 11 | 0.05238095238 |  |  |  |  | 1 | 0.8882352941 | 0
80 | 16 | 560 | 640 | 50 | yes | Yellow/Black | L031K6 | 2x 3D glass shutter | 560/640 | SDL late | 5 | 26 | 4.4 | 2.4 | 0 |  | 240 | ? | 240 | 35 | 296 | 0.118243 | 1 | 1 | 1.000 | 67 |  |  | 52 | 0.2791666667 | 15 | 0.0625 |  |  |  |  | 1 | 0.8817567568 | 0
81 | 16 | 560 | 640 | 50 | yes | Yellow/Black | L031K6 | 2x 3D glass shutter | 560/640 | SDL late | 5 | 26 | 4.4 | 2.5 | 0 | 60 | 270 | 60 | 270 | 30 | 280 | 0.107143 | 1 | 1 | 1.000 | 72 |  |  | 52 | 0.2666666667 | 20 | 0.07407407407 |  |  |  |  | 1 | 0.8928571429 | 0
82 | 16 | 560 | 640 | 50 | yes | Yellow/Black | L031K6 | 2x 3D glass shutter | 560/640 | SDL late | 5 | 26 | 4.4 | 2.6 | 0 |  | 250 | ? | 250 | 21 | 192 | 0.109375 | 1 | 1 | 1.000 | 71 |  |  | 52 | 0.284 | 19 | 0.076 |  |  |  |  | 1 | 0.890625 | 0
83 | 16 | 560 | 640 | 50 | yes | Yellow/Black | L031K6 | 2x 3D glass shutter | 560/640 | SDL late | 5 | 26 | 4.4 | 2.8 | 0 |  | 280 | ? | 280 | inf | 0 | 1.000000 | inf | 0 | 1.000 | 82 |  |  | 52 | 0.2928571429 | 30 | 0.1071428571 |  |  |  |  | 1 | 0 | 0
84 | 16 | 560 | 640 | 50 | yes | Yellow/Black | L031K6 | 2x 3D glass shutter | 560/640 | SDL late | 5 | 26 | 4.4 | 3 | 0 | 60 | 320 | 60 | 320 | 63 | 576 | 0.109375 | 1 | 1 | 1.000 | 85 |  |  | 52 | 0.265625 | 33 | 0.103125 |  |  |  |  | 1 | 0.890625 | 0
85 | 16 | 560 | 640 | 50 | yes | Yellow/Black | L031K6 | 2x 3D glass shutter | 560/640 | SDL late | 5 | 26 | 4.4 | 3 |  |  | 310 | ? | 310 |  |  |  |  |  |  |  |  |  |  |  |  |  |  |  |  |  | 1
86 | 16 | 560 | 640 | 50 | yes | Yellow/Black | L031K6 | 2x 3D glass shutter | 560/640 | SDL late | 5 | 26 | 4.4 | 3.2 |  |  | 330 | ? | 330 |  |  |  |  |  |  |  |  |  |  |  |  |  |  |  |  |  | 1
87 | 16 | 560 | 640 | 50 | yes | Yellow/Black | L031K6 | 2x 3D glass shutter | 560/640 | SDL late | 5 | 26 | 4.4 | 3.4 |  |  | 350 | ? | 350 |  |  |  |  |  |  |  |  |  |  |  |  |  |  |  |  |  | 1
88 | 16 | 560 | 640 | 50 | yes | Yellow/Black | L031K6 | 2x 3D glass shutter | 560/640 | SDL late | 5 | 26 | 4.4 | 3.6 |  |  | 360 | ? | 360 |  |  |  |  |  |  |  |  |  |  |  |  |  |  |  |  |  | 1
89 | 16 | 560 | 640 | 50 | yes | Yellow/Black | L031K6 | 2x 3D glass shutter | 560/640 | SDL late | 5 | 26 | 4.4 | 3.8 |  |  | 420 | ? | 420 |  |  |  |  |  |  |  |  |  |  |  |  |  |  |  |  |  | 2
90 | 16 | 560 | 640 | 50 | yes | Yellow/Black | L031K6 | 2x 3D glass shutter | 560/640 | SDL late | 5 | 26 | 4.4 | 4 |  |  | 460 | ? | 460 |  |  |  |  |  |  |  |  |  |  |  |  |  |  |  |  |  | 2
91 | 16 | 560 | 640 | 50 | yes | Yellow/Black | L031K6 | 2x 3D glass shutter | 560/640 | SDL late | 5 | 26 | 4.4 | 4.2 |  |  | 460 | ? | 460 |  |  |  |  |  |  |  |  |  |  |  |  |  |  |  |  |  | 2
92 | 16 | 560 | 640 | 50 | yes | Yellow/Black | L031K6 | 2x 3D glass shutter | 560/640 | SDL late | 5 | 26 | 4.4 | 4.4 |  |  | 410 | ? | 410 |  |  |  |  |  |  |  |  |  |  |  |  |  |  |  |  |  | 2
93 | 16 | 560 | 640 | 50 | yes | Yellow/Black | L031K6 | 2x 3D glass shutter | 560/640 | SDL late | 5 | 26 | 4.4 | 4.6 |  |  | 380 | ? | 380 |  |  |  |  |  |  |  |  |  |  |  |  |  |  |  |  |  | 1
94 | 16 | 560 | 640 | 50 | yes | Yellow/Black | L031K6 | 2x 3D glass shutter | 560/640 | SDL late | 5 | 26 | 4.4 | 4.8 |  |  | 370 | ? | 370 |  |  |  |  |  |  |  |  |  |  |  |  |  |  |  |  |  | 1
95 | 16 | 560 | 640 | 50 | yes | Yellow/Black | L031K6 | 2x 3D glass shutter | 560/640 | SDL late | 5 | 26 | 4.4 | 5 |  |  | 370 | ? | 370 |  |  |  |  |  |  |  |  |  |  |  |  |  |  |  |  |  | 1
96 | 16 | 560 | 640 | 50 | yes | Yellow/Black | L031K6 | 2x 3D glass shutter | 560/640 | SDL late | 5 | 26 | 4.4 | 5.2 |  |  | 370 | ? | 370 |  |  |  |  |  |  |  |  |  |  |  |  |  |  |  |  |  | 1
97 | 16 | 560 | 640 | 50 | yes | Yellow/Black | L031K6 | 2x 3D glass shutter | 560/640 | SDL late | 5 | 26 | 4.4 | 5.4 |  |  | 370 | ? | 370 |  |  |  |  |  |  |  |  |  |  |  |  |  |  |  |  |  | 1
98 | 16 | 560 | 640 | 50 | yes | Yellow/Black | L031K6 | 2x 3D glass shutter | 560/640 | SDL late | 5 | 26 | 4.4 | 5.6 |  |  | 390 | ? | 390 |  |  |  |  |  |  |  |  |  |  |  |  |  |  |  |  |  | 1
99 | 16 | 560 | 640 | 50 | yes | Yellow/Black | L031K6 | 2x 3D glass shutter | 560/640 | SDL late | 5 | 26 | 4.4 | 5.8 |  |  | 400 | ? | 400 |  |  |  |  |  |  |  |  |  |  |  |  |  |  |  |  |  | 2
100 | 16 | 560 | 640 | 50 | yes | Yellow/Black | L031K6 | 2x 3D glass shutter | 560/640 | SDL late | 5 | 26 | 4.4 | 6 |  |  | 390 | ? | 390 |  |  |  |  |  |  |  |  |  |  |  |  |  |  |  |  |  | 1
101 | 16 | 560 | 640 | 50 | yes | Yellow/Black | L031K6 | 2x 3D glass shutter | 560/640 | SDL late | 5 | 26 | 4.4 | 6.2 |  |  | 350 | ? | 350 |  |  |  |  |  |  |  |  |  |  |  |  |  |  |  |  |  | 1
102 | 16 | 560 | 640 | 50 | yes | Yellow/Black | L031K6 | 2x 3D glass shutter | 560/640 | SDL late | 5 | 26 | 4.4 | 6.4 |  |  | 340 | ? | 340 |  |  |  |  |  |  |  |  |  |  |  |  |  |  |  |  |  | 1
103 | 16 | 560 | 640 | 50 | yes | Yellow/Black | L031K6 | 2x 3D glass shutter | 560/640 | SDL late | 5 | 26 | 4.4 | 6.6 |  |  | 310 | ? | 310 |  |  |  |  |  |  |  |  |  |  |  |  |  |  |  |  |  | 1
104 | 16 | 560 | 640 | 50 | yes | Yellow/Black | L031K6 | 2x 3D glass shutter | 560/640 | SDL late | 5 | 26 | 4.4 | 6.8 |  |  | 290 | ? | 290 |  |  |  |  |  |  |  |  |  |  |  |  |  |  |  |  |  | 1
105 | 16 | 560 | 640 | 50 | yes | Yellow/Black | L031K6 | 2x 3D glass shutter | 560/640 | SDL late | 5 | 26 | 4.4 | 7 |  |  | 280 | ? | 280 |  |  |  |  |  |  |  |  |  |  |  |  |  |  |  |  |  | 1
106 | 16 | 560 | 640 | 50 | yes | Yellow/Black | L031K6 | 2x 3D glass shutter | 560/640 | SDL late | 5 | 26 | 4.4 | 7.2 |  |  | 290 | ? | 290 |  |  |  |  |  |  |  |  |  |  |  |  |  |  |  |  |  | 1
107 | 16 | 560 | 640 | 50 | yes | Yellow/Black | L031K6 | 2x 3D glass shutter | 560/640 | SDL late | 5 | 26 | 4.4 | 7.4 |  |  | 300 | ? | 300 |  |  |  |  |  |  |  |  |  |  |  |  |  |  |  |  |  | 1
108 | 16 | 560 | 640 | 50 | yes | Yellow/Black | L031K6 | 2x 3D glass shutter | 560/640 | SDL late | 5 | 26 | 4.4 | 7.6 |  |  | 320 | ? | 320 |  |  |  |  |  |  |  |  |  |  |  |  |  |  |  |  |  | 1
109 | 16 | 560 | 640 | 50 | yes | Yellow/Black | L031K6 | 2x 3D glass shutter | 560/640 | SDL late | 5 | 26 | 4.4 | 7.8 |  |  | 340 | ? | 340 |  |  |  |  |  |  |  |  |  |  |  |  |  |  |  |  |  | 1
110 | 16 | 560 | 640 | 50 | yes | Yellow/Black | L031K6 | 2x 3D glass shutter | 560/640 | SDL late | 5 | 26 | 4.4 | 8 |  |  | 350 | ? | 350 |  |  |  |  |  |  |  |  |  |  |  |  |  |  |  |  |  | 1
111 | 17 | 560 | 640 | 50 | yes | Yellow/Black | L031K6 | no shutter |  | SDL day + LED | 6 | 0 | 4.35 | - | - | 110 |  | 110 | ? |  |  |  |  |  |  | 184 |  |  |  |  |  |  |  |  |  |  | 0
112 | 18 | 560 | 640 | 50 | yes | Yellow/Black | L031K6 | 2x 3D glass shutter | 560/640 | SDL day + LED | 6 | 26 | 4.35 | 0.6 | 0 |  | 720 | ? | 720 | 0 | 4000 | 0.000000 | 0 | 15 | 0.000 | 676 |  |  |  | 0.9388888889 |  |  |  |  |  |  | 2 | 1 | 1
113 | 18 | 560 | 640 | 50 | yes | Yellow/Black | L031K6 | 2x 3D glass shutter | 560/640 | SDL day + LED | 6 | 26 | 4.35 | 0.6 | 5 |  | 530 | ? | 530 | inf | 0 | 1.000000 | inf | 0 | 1.000 | 199 |  |  |  | 0.3754716981 |  |  |  |  |  |  | 0 | 0 | 0
114 | 18 | 560 | 640 | 50 | yes | Yellow/Black | L031K6 | 2x 3D glass shutter | 560/640 | SDL day + LED | 6 | 26 | 4.35 | 0.6 | 2 |  | 600 | ? | 600 | inf | 0 | 1.000000 | inf | 0 | 1.000 | 195 |  |  |  | 0.325 |  |  |  |  |  |  | 0 | 0 | 0
115 | 18 | 560 | 640 | 50 | yes | Yellow/Black | L031K6 | 2x 3D glass shutter | 560/640 | SDL day + LED | 6 | 26 | 4.35 | 0.6 | 1 |  | 590 | ? | 590 | 0 | 5000 | 0.000000 | 0 | 17 | 0.000 | 313 |  |  |  | 0.5305084746 |  |  |  |  |  |  | 0 | 1 | 1
116 | 18 | 560 | 640 | 50 | yes | Yellow/Black | L031K6 | 2x 3D glass shutter | 560/640 | SDL day + LED | 6 | 26 | 4.35 | 0.6 | -1 |  | 700 | ? | 700 | 0 | 3760 | 0.000000 | 0 | 13 | 0.000 | 341 |  |  |  | 0.4871428571 |  |  |  |  |  |  | 0 | 1 | 1
117 | 18 | 560 | 640 | 50 | yes | Yellow/Black | L031K6 | 2x 3D glass shutter | 560/640 | SDL day + LED | 6 | 26 | 4.35 | 0.6 | -2 |  |  | ? | ? | 0 | 10000 | 0.000000 | 0 | 63 | 0.000 |  |  |  |  |  |  |  |  |  |  |  | 0 | 1 | 1
118 | 18 | 560 | 640 | 50 | yes | Yellow/Black | L031K6 | 2x 3D glass shutter | 560/640 | SDL day + LED | 6 | 26 | 4.35 | 0.6 | -3 |  |  | ? | ? |  |  |  |  |  |  |  |  |  |  |  |  |  |  |  |  |  | 0
119 | 18 | 560 | 640 | 50 | yes | Yellow/Black | L031K6 | 2x 3D glass shutter | 560/640 | SDL day + LED | 6 | 26 | 4.35 | 0.6 |  |  |  | ? | ? |  |  |  |  |  |  |  |  |  |  |  |  |  |  |  |  |  | 0
120 | 18 | 560 | 640 | 50 | yes | Yellow/Black | L031K6 | 2x 3D glass shutter | 560/640 | SDL day + LED | 6 | 26 | 4.35 | 0.6 |  |  |  | ? | ? |  |  |  |  |  |  |  |  |  |  |  |  |  |  |  |  |  | 0
121 | 18 | 560 | 640 | 50 | yes | Yellow/Black | L031K6 | 2x 3D glass shutter | 560/640 | SDL day + LED | 6 | 26 | 4.35 | 0.6 |  |  |  | ? | ? |  |  |  |  |  |  |  |  |  |  |  |  |  |  |  |  |  | 0
122 | 18 | 560 | 640 | 50 | yes | Yellow/Black | L031K6 | 2x 3D glass shutter | 560/640 | SDL day + LED | 6 | 26 | 4.35 |  |  |  |  | ? | ? |  |  |  |  |  |  |  |  |  |  |  |  |  |  |  |  |  | 0
123 | 18 | 560 | 640 | 50 | yes | Yellow/Black | L031K6 | 2x 3D glass shutter | 560/640 | SDL day + LED | 6 | 26 | 4.35 |  |  |  |  | ? | ? |  |  |  |  |  |  |  |  |  |  |  |  |  |  |  |  |  | 0
124 | 18 | 560 | 640 | 50 | yes | Yellow/Black | L031K6 | 2x 3D glass shutter | 560/640 | SDL day + LED | 6 | 26 | 4.35 |  |  |  |  | ? | ? |  |  |  |  |  |  |  |  |  |  |  |  |  |  |  |  |  | 0
125 | 19 | 560 | 640 | 50 | yes | Yellow/Black | L031K6 | 2x 3D glass shutter | 560/640 | outdoor sun | 7 | 26 | 4.35 | 5 | 0 |  | 22k | ? | 22000 |  |  |  |  |  |  | sat |  |  |  | #VALUE! |  |  |  |  |  |  | 4
126 | 20 | 560 | 640 | 50 | yes | Yellow/Black | L031K6 | 2x 3D glass shutter | 560/640 | EWI 13 cloudy +TL | 8 | 26 | 4.35 | 0.5 | 0 |  |  | ? | ? |  |  |  |  |  |  |  |  |  |  |  |  |  |  |  |  |  | 0
127 | 20 | 560 | 640 | 50 | yes | Yellow/Black | L031K6 | 2x 3D glass shutter | 560/640 | EWI 13 cloudy +TL | 8 | 26 | 4.35 | 1 | 0 |  |  | ? | ? |  |  |  |  |  |  |  |  |  |  |  |  |  |  |  |  |  | 0
128 | 20 | 560 | 640 | 50 | yes | Yellow/Black | L031K6 | 2x 3D glass shutter | 560/640 | EWI 13 cloudy +TL | 8 | 26 | 4.35 | 1.5 | 0 |  | 180 | ? | 180 | inf | 0 | 1.000000 | inf | 0 | 1.000 | 134 |  |  |  | 0.7444444444 |  |  |  |  |  |  | 1 | 0 | 0
129 | 20 | 560 | 640 | 50 | yes | Yellow/Black | L031K6 | 2x 3D glass shutter | 560/640 | EWI 13 cloudy +TL | 8 | 26 | 4.35 | 2 | 0 |  | 170 | ? | 170 | inf | 0 | 1.000000 | inf | 0 | 1.000 | 123 |  |  |  | 0.7235294118 |  |  |  |  |  |  | 1 | 0 | 0
130 | 20 | 560 | 640 | 50 | yes | Yellow/Black | L031K6 | 2x 3D glass shutter | 560/640 | EWI 13 cloudy +TL | 8 | 26 | 4.35 | 2.5 | 0 |  | 200 | ? | 200 | 77 | 7000 | 0.011000 | 8 | 25 | 0.320 | 119 |  |  |  | 0.595 |  |  |  |  |  |  | 1 | 0.989 | 0.68
131 | 20 | 560 | 640 | 50 | yes | Yellow/Black | L031K6 | 2x 3D glass shutter | 560/640 | EWI 13 cloudy +TL | 8 | 26 | 4.35 | 3 | 0 |  |  | ? | ? |  |  |  |  |  |  |  |  |  |  |  |  |  |  |  |  |  | 0
132 | 21 | 560 | 640 | 50 | yes | Yellow/Black | L031K6 | 2x 3D glass shutter | 560/640 | VMB6/6 LED+cloud | 9 | 26 | 4.35 | 0.5 | 0 |  | 660 | ? | 660 | 0 | 7000 | 0.000000 | 0 | 25 | 0.000 | 3108 |  |  |  | 4.709090909 |  |  |  |  |  |  | 2 | 1 | 1
133 | 21 | 560 | 640 | 50 | yes | Yellow/Black | L031K6 | 2x 3D glass shutter | 560/640 | VMB6/6 LED+cloud | 9 | 26 | 4.35 | 1 | 0 |  | 460 | ? | 460 | 0 | 7000 | 0.000000 | 0 | 25 | 0.000 | 1274 |  |  |  | 2.769565217 |  |  |  |  |  |  | 2 | 1 | 1
134 | 21 | 560 | 640 | 50 | yes | Yellow/Black | L031K6 | 2x 3D glass shutter | 560/640 | VMB6/6 LED+cloud | 9 | 26 | 4.35 | 1.5 | 0 |  | 450 | ? | 450 | 0 | 7000 | 0.000000 | 0 | 25 | 0.000 | 1018 |  |  |  | 2.262222222 |  |  |  |  |  |  | 2 | 1 | 1
135 | 21 | 560 | 640 | 50 | yes | Yellow/Black | L031K6 | 2x 3D glass shutter | 560/640 | VMB6/6 LED+cloud | 9 | 26 | 4.35 | 2 | 0 |  | 440 | ? | 440 | 12 | 6700 | 0.001791 | 4 | 24 | 0.167 | 702 |  |  |  | 1.595454545 |  |  |  |  |  |  | 2 | 0.9982089552 | 0.8333333333
136 | 21 | 560 | 640 | 50 | yes | Yellow/Black | L031K6 | 2x 3D glass shutter | 560/640 | VMB6/6 LED+cloud | 9 | 26 | 4.35 | 2.5 | 0 |  | 250 | ? | 250 | 39 | 2320 | 0.016810 | 6 | 8 | 0.750 | 917 |  | 770 |  | 3.668 |  |  |  |  |  |  | 1 | 0.9831896552 | 0.25
137 | 22 | 560 | 640 | 50 | yes | Yellow/Black | L031K6 | - | 560/640 | VMB6/6 LED+cloud | 9 | 0 | 4.35 | - | - |  | - | ? | ? |  |  |  |  |  |  | 2749 |  | 2829 |  |  |  |  |  |  |  |  | 0
138 | 23 | 560 | 640 | 50 | yes | Yellow/Black + pol | L031K6 | 2x shutter without pol | 560/640 | VMB6/6 LED+cloud | 9 | 26 | 4.35 | 1 | 0 |  | 470 | ? | 470 | 0 | 7000 | 0.000000 | 0 | 25 | 0.000 | 497 |  | 1188 |  | 1.057446809 |  |  |  |  |  |  | 2 | 1 | 1
139 | 23 | 560 | 640 | 50 | yes | Yellow/Black + pol | L031K6 | 2x shutter without pol | 560/640 | VMB6/6 LED+cloud | 9 | 26 | 4.35 | 1.5 | 0 |  | 440 | ? | 440 | 0 | 7000 | 0.000000 | 0 | 25 | 0.000 | 366 |  | 717 |  | 0.8318181818 |  |  |  |  |  |  | 2 | 1 | 1
140 | 23 | 560 | 640 | 50 | yes | Yellow/Black + pol | L031K6 | 2x shutter without pol | 560/640 | VMB6/6 LED+cloud | 9 | 26 | 4.35 | 2 | 0 |  | 440 | ? | 440 | 0 | 7000 | 0.000000 | 0 | 25 | 0.000 | 314 |  | 584 |  | 0.7136363636 |  |  |  |  |  |  | 2 | 1 | 1
141 | 23 | 560 | 640 | 50 | yes | Yellow/Black + pol | L031K6 | 2x shutter without pol | 560/640 | VMB6/6 LED+cloud | 9 | 26 | 4.35 | 2.5 | 0 |  | 280 | ? | 280 | 1 | 7000 | 0.000143 | 0 | 25 | 0.000 | 221 |  |  |  | 0.7892857143 |  |  |  |  |  |  | 1 | 0.9998571429 | 1
142 | 23 | 560 | 640 | 50 | yes | Yellow/Black + pol | L031K6 | 2x shutter without pol | 560/640 | VMB6/6 LED+cloud | 9 | 26 | 4.35 | 3 | 0 |  | 290 | ? | 290 | 80 | 3000 | 0.026667 | 10 | 11 | 0.909 | 206 |  | 147 |  | 0.7103448276 |  |  |  |  |  |  | 1 | 0.9733333333 | 0.09090909091
143 | 24 | 560 | 640 | 50 | yes | Yellow/Black + pol | L031K6 | - | 560/640 | VMB6/6 LED+cloud | 9 | 0 | 4.35 |  |  |  |  | ? | ? |  |  |  |  |  |  | 427 |  | 243 |  |  |  |  |  |  |  |  | 0
144 | 25 | 560 | 640 | 50 | yes | Y/B pol rotated | L031K6 | - | 560/640 | VMB6/6 LED+cloud | 9 | 0 | 4.35 |  |  |  |  | ? | ? |  |  |  |  |  |  | 385 |  | 171 |  |  |  |  |  |  |  |  | 0
145 | 26 | 560 | 640 | 50 | yes | ? | L031K6 | - | 560/640 | indoor | 10 | 0 | ? |  |  |  |  | ? | ? |  |  |  |  |  |  |  |  |  |  |  |  |  | 0 | 0 | 0 | 0 | 0
146 | 26 | 560 | 640 | 50 | yes | ? | L031K6 | - | 560/640 | indoor | 10 | 0 | ? |  |  |  |  | ? | ? |  |  |  |  |  |  |  |  |  |  |  |  |  | 4 | 60 | 0.04 | 0.6 | 0
147 | 26 | 560 | 640 | 50 | yes | ? | L031K6 | - | 560/640 | indoor | 10 | 0 | ? |  |  |  |  | ? | ? |  |  |  |  |  |  |  |  |  |  |  |  |  | 5 | 80 | 0.05 | 0.8 | 0
148 | 26 | 560 | 640 | 50 | yes | ? | L031K6 | - | 560/640 | indoor | 10 | 0 | ? |  |  |  |  | ? | ? |  |  |  |  |  |  |  |  |  |  |  |  |  | 5.5 | 100 | 0.055 | 1 | 0
149 | 26 | 560 | 640 | 50 | yes | ? | L031K6 | - | 560/640 | indoor | 10 | 0 | ? |  |  |  |  | ? | ? |  |  |  |  |  |  |  |  |  |  |  |  |  | 6 | 150 | 0.06 | 1.5 | 0
150 | 26 | 560 | 640 | 50 | yes | ? | L031K6 | - | 560/640 | indoor | 10 | 0 | ? |  |  |  |  | ? | ? |  |  |  |  |  |  |  |  |  |  |  |  |  | 6 | 200 | 0.06 | 2 | 0
151 | 26 | 560 | 640 | 50 | yes | ? | L031K6 | - | 560/640 | indoor | 10 | 0 | ? |  |  |  |  | ? | ? |  |  |  |  |  |  |  |  |  |  |  |  |  | 5 | 250 | 0.05 | 2.5 | 0
152 | 26 | 560 | 640 | 50 | yes | ? | L031K6 | - | 560/640 | indoor | 10 | 0 | ? |  |  |  |  | ? | ? |  |  |  |  |  |  |  |  |  |  |  |  |  | 6 | 250 | 0.06 | 2.5 | 0
153 | 26 | 560 | 640 | 50 | yes | ? | L031K6 | - | 560/640 | indoor | 10 | 0 | ? |  |  |  |  | ? | ? |  |  |  |  |  |  |  |  |  |  |  |  |  | 6 | 300 | 0.06 | 3 | 0
154 | 26 | 560 | 640 | 50 | yes | ? | L031K6 | - | 560/640 | indoor | 10 | 0 | ? |  |  |  |  | ? | ? |  |  |  |  |  |  |  |  |  |  |  |  |  | 6 | 350 | 0.06 | 3.5 | 0
155 | 26 | 560 | 640 | 50 | yes | ? | L031K6 | - | 560/640 | indoor | 10 | 0 | ? |  |  |  |  | ? | ? |  |  |  |  |  |  |  |  |  |  |  |  |  | 7 | 400 | 0.07 | 4 | 0
156 | 26 | 560 | 640 | 50 | yes | ? | L031K6 | - | 560/640 | indoor | 10 | 0 | ? |  |  |  |  | ? | ? |  |  |  |  |  |  |  |  |  |  |  |  |  | 6 | 450 | 0.06 | 4.5 | 0
157 | 26 | 560 | 640 | 50 | yes | ? | L031K6 | - | 560/640 | indoor | 10 | 0 | ? |  |  |  |  | ? | ? |  |  |  |  |  |  |  |  |  |  |  |  |  | 4 | 475 | 0.04 | 4.75 | 0
158 | 26 | 560 | 640 | 50 | yes | ? | L031K6 | - | 560/640 | indoor | 10 | 0 | ? |  |  |  |  | ? | ? |  |  |  |  |  |  |  |  |  |  |  |  |  | 4 | 475 | 0.04 | 4.75 | 0
159 | 26 | 560 | 640 | 50 | yes | ? | L031K6 | - | 560/640 | indoor | 10 | 0 | ? |  |  |  |  | ? | ? |  |  |  |  |  |  |  |  |  |  |  |  |  | 3 | 450 | 0.03 | 4.5 | 0
160 | 26 | 560 | 640 | 50 | yes | ? | L031K6 | - | 560/640 | indoor | 10 | 0 | ? |  |  |  |  | ? | ? |  |  |  |  |  |  |  |  |  |  |  |  |  | 1 | 400 | 0.01 | 4 | 0
161 | 26 | 560 | 640 | 50 | yes | ? | L031K6 | - | 560/640 | indoor | 10 | 0 | ? |  |  |  |  | ? | ? |  |  |  |  |  |  |  |  |  |  |  |  |  | 0 | 350 | 0 | 3.5 | 0
162 | 26 | 560 | 640 | 50 | yes | ? | L031K6 | - | 560/640 | indoor | 10 | 0 | ? |  |  |  |  | ? | ? |  |  |  |  |  |  |  |  |  |  |  |  |  | -1 | 300 | -0.01 | 3 | 0
163 | 26 | 560 | 640 | 50 | yes | ? | L031K6 | - | 560/640 | indoor | 10 | 0 | ? |  |  |  |  | ? | ? |  |  |  |  |  |  |  |  |  |  |  |  |  | -1 | 250 | -0.01 | 2.5 | 0
164 | 26 | 560 | 640 | 50 | yes | ? | L031K6 | - | 560/640 | indoor | 10 | 0 | ? |  |  |  |  | ? | ? |  |  |  |  |  |  |  |  |  |  |  |  |  | 1 | 250 | 0.01 | 2.5 | 0
165 | 26 | 560 | 640 | 50 | yes | ? | L031K6 | - | 560/640 | indoor | 10 | 0 | ? |  |  |  |  | ? | ? |  |  |  |  |  |  |  |  |  |  |  |  |  | 1 | 200 | 0.01 | 2 | 0
166 | 26 | 560 | 640 | 50 | yes | ? | L031K6 | - | 560/640 | indoor | 10 | 0 | ? |  |  |  |  | ? | ? |  |  |  |  |  |  |  |  |  |  |  |  |  | 0 | 150 | 0 | 1.5 | 0
167 | 26 | 560 | 640 | 50 | yes | ? | L031K6 | - | 560/640 | indoor | 10 | 0 | ? |  |  |  |  | ? | ? |  |  |  |  |  |  |  |  |  |  |  |  |  | -1 | 100 | -0.01 | 1 | 0
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
229 | 28 | 560 | 640 | 50 | yes | ? | L031K6 | - | 560/640 | outdoor | 11 | 0 | ? |  |  |  |  | ? | ? |  |  |  |  |  |  |  |  |  |  |  |  |  |  |  |  |  | 0
 |  |  |  |  |  |  |  |  |  |  |  |  |  |  |  |  |  |  |  |  |  |  |  |  |  |  |  |  |  |  |  |  |  |  |  |  | 0

Sheet: Coverage
Coverage indoor SDL 500-700 lux |  |  |  |  | Outdoor |  |  |  |  | 250-300 lux |  |  | 148
 |  |  |  |  |  | offsets in cm
distance (cm) | NC | offset min | offset max | NC | distance (m) | NC | offset min | offset max | NC | dist (cm) | NC | offset min | offset max | NC
60 | -5 | -4 | 1 | 2 | 5 | -15 | -14 | 14 | 15 | 50 | 95 | 96 | 103 | 104
80 | -6 | -5 | 1 | 2 | 10 | -25 | -24 | 24 | 25 | 100 | 95 | 96 | 103 | 104
100 | -6 | -5.5 | 1 | 2 | 15 | -35 | -34 | 34 | 35 | 150 | 95 | 96 | 104 | 105
150 | -7 | -6 | 0 | 1 | 20 | -44 | -43 | 44 | 45 | 200 | 95 | 96 | 103.5 | 104.5
200 | -7 | -6 | -1 | 0 | 25 | -41 | -40 | 45 | 46 | 250 | 94.5 | 95 | 103.5 | 104.5
250 | -6 | -5 | -1 | 0 | 30 | -34 | -33 | 62 | 63 | 300 | 95 | 96 | 103 | 104
 |  |  |  |  | 35 | -39 | -38 | 70 | 71 | 350 | 96 | 97 | 101 | 102
250 | -7 | -6 | 1 | 2 | 40 | -45 | -44 | 76 | 77 | 400 | 98 | 99 | 100 | 101
300 | -7 | -6 | 1 | 2 | 45 | -41 | -40 | 58 | 59 | 450 |  | - | -
350 | -8 | -6 | 0 | 1 | 50 | -43 | -42 | 65 | 66
400 | -8 | -7 | -1 | 0 | 55 | -45 | -44 | 65 | 66
450 | -7 | -6 | -3 | -2 | 60 | -31 | -30 | 59 | 60
475 | -5 | -4 | -4 | -3 | 65 | -30 | -29 | 56 | 57
500 | -4 |  |  | -4
 |  |  |  |  |  |  |  |  |  | 600 lux
 |  |  |  |  |  |  |  |  |  | dist (cm) | NC | offset min | offset max | NC
 |  |  |  |  |  |  |  |  |  | 50 | -5 | 4 | 2 | 3
 |  |  |  |  |  |  |  |  |  | 100 | -5 | -4 | 3 | 4
 |  |  |  |  |  |  |  |  |  | 150 | -4.5 | -3.5 | 2 | 3
 |  |  |  |  |  |  |  |  |  | 200 | -2 | -1.5 | 2 | 3
 |  |  |  |  |  |  |  |  |  | 250 | -1 | 0 | 0 | 1
