RensBloom/LuxSenz/openSCAD/transmitter_reflective_shield.stl

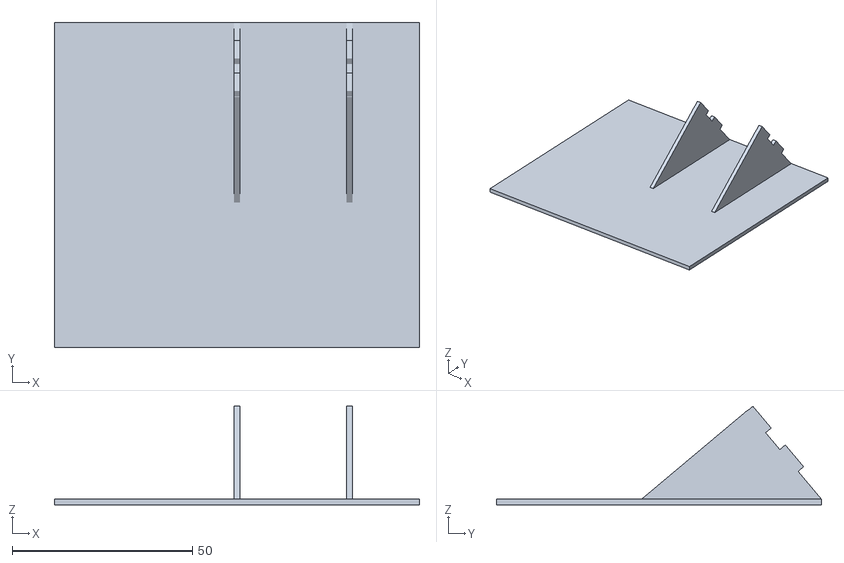
[picture p28: CAD file, 2020-05-22]
openSCAD/transmitter_reflective_shield.stl
101.2 x 90.0 x 27.3
