RensBloom/LuxSenz/openSCAD/beaglebone_casing_bottom.stl

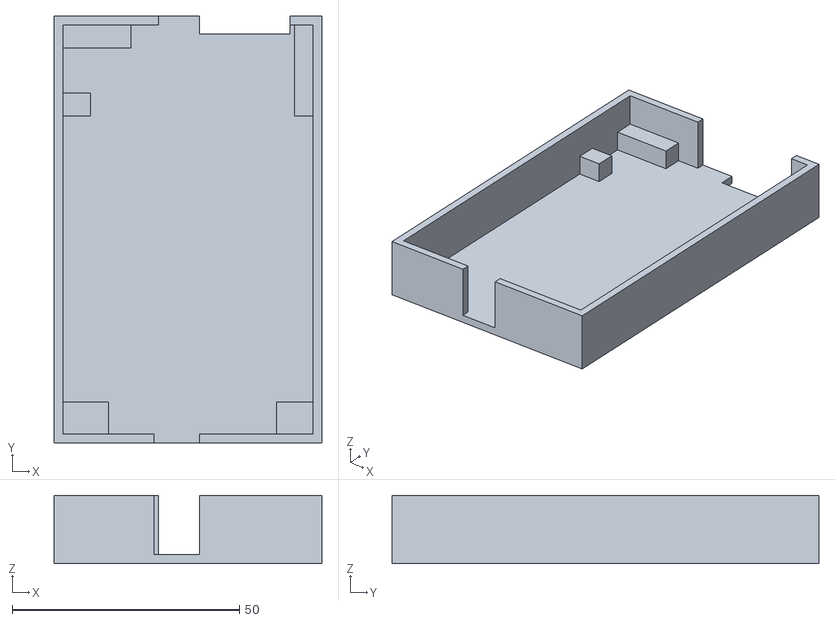
[picture p29: CAD file, 2020-05-22]
openSCAD/beaglebone_casing_bottom.stl
59.0 x 94.0 x 15.0
