RensBloom/LuxSenz/openSCAD/transmitter_block_3d_glass_shutter.stl

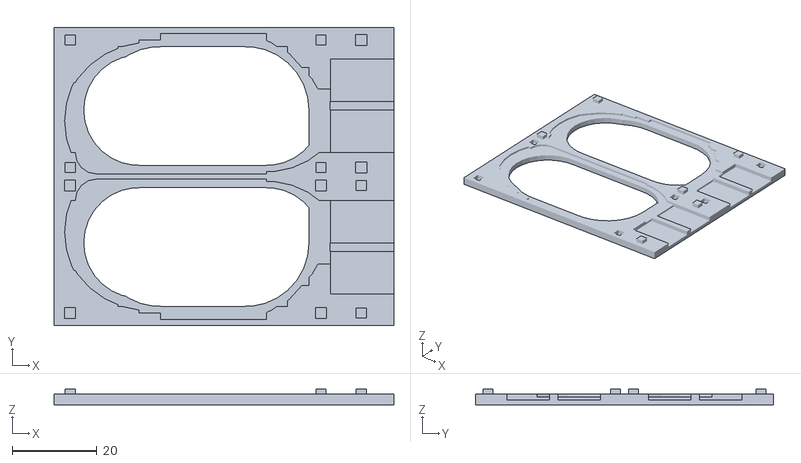
[picture p30: CAD file, 2020-05-22]
openSCAD/transmitter_block_3d_glass_shutter.stl
80.0 x 70.0 x 3.70
