RensBloom/LuxSenz/openSCAD/beaglebone_casing_top.stl

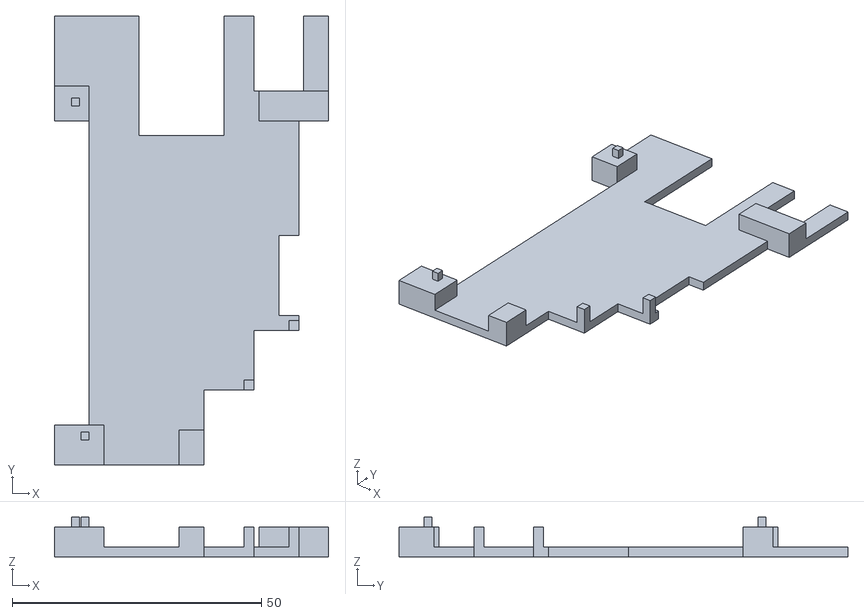
[picture p31: CAD file, 2020-05-22]
openSCAD/beaglebone_casing_top.stl
55.0 x 90.0 x 8.00
