RensBloom/LuxSenz/openSCAD/transmitter_case.stl

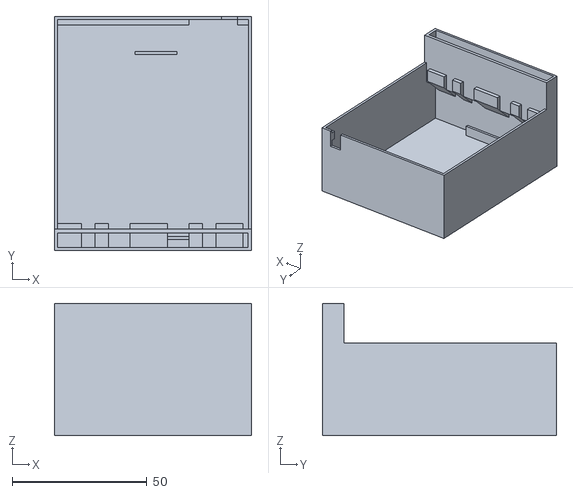
[picture p32: CAD file, 2020-05-22]
openSCAD/transmitter_case.stl
73.2 x 86.9 x 49.2
