RensBloom/LuxSenz/openSCAD/transmitter_block_video_shutter.stl

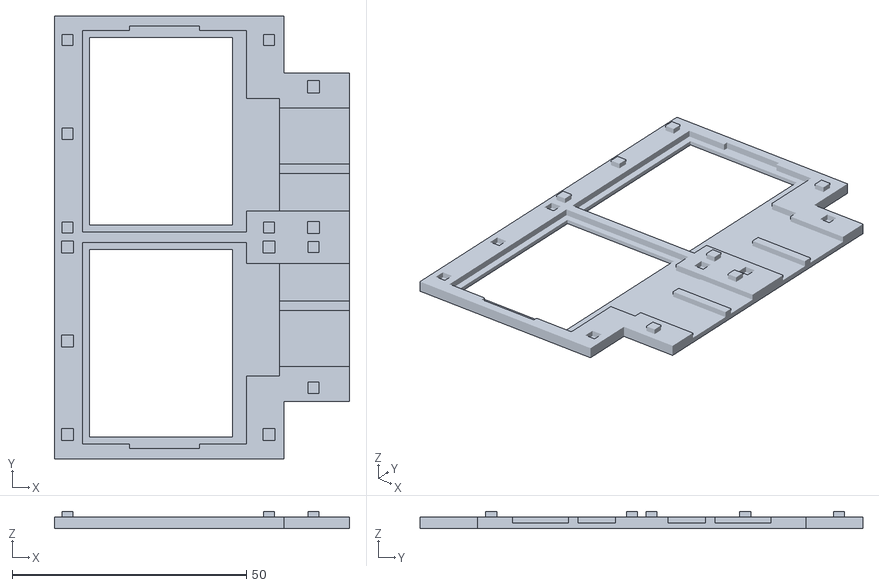
[picture p33: CAD file, 2020-05-22]
openSCAD/transmitter_block_video_shutter.stl
63.0 x 94.5 x 3.70
