RensBloom/LuxSenz/openSCAD/transceiver_pcb_case.stl

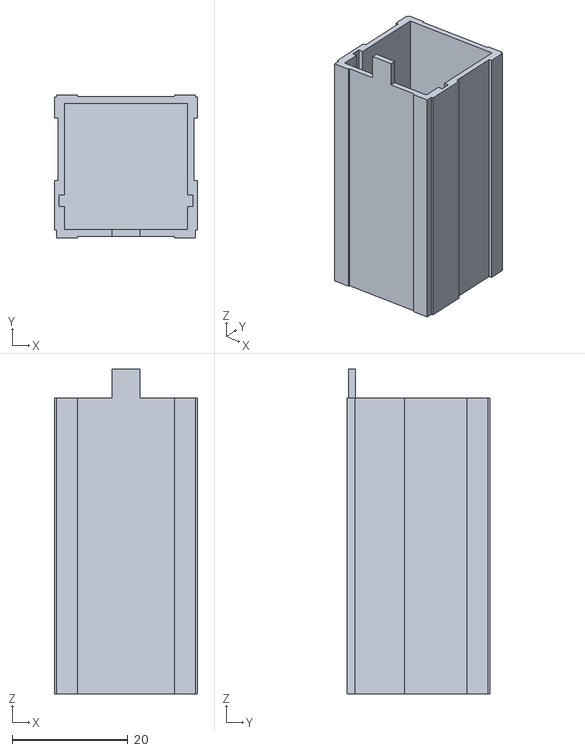
[picture p34: CAD file, 2020-05-22]
openSCAD/transceiver_pcb_case.stl
24.8 x 24.8 x 56.2
