RensBloom/LuxSenz/openSCAD/receiver_block_lens_25mm.stl

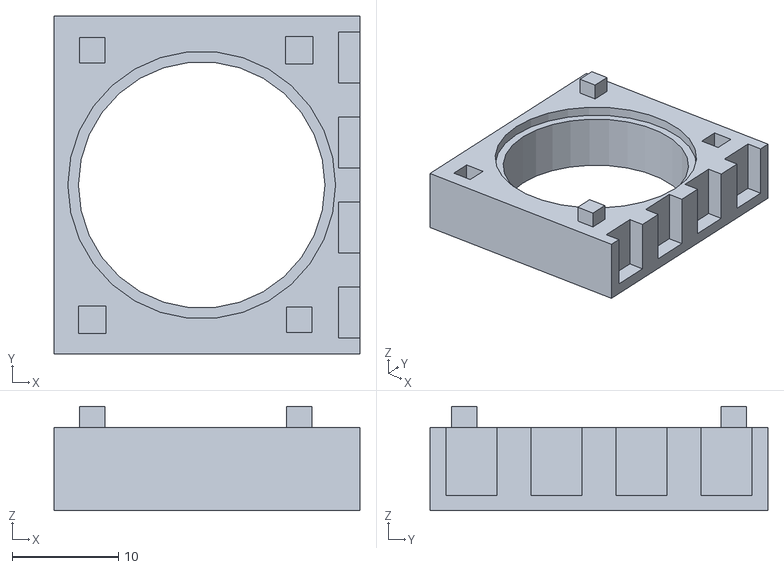
[picture p35: CAD file, 2020-05-22]
openSCAD/receiver_block_lens_25mm.stl
28.8 x 31.8 x 9.80
