RensBloom/LuxSenz/openSCAD/transceiver_block_video_shutter_a.stl

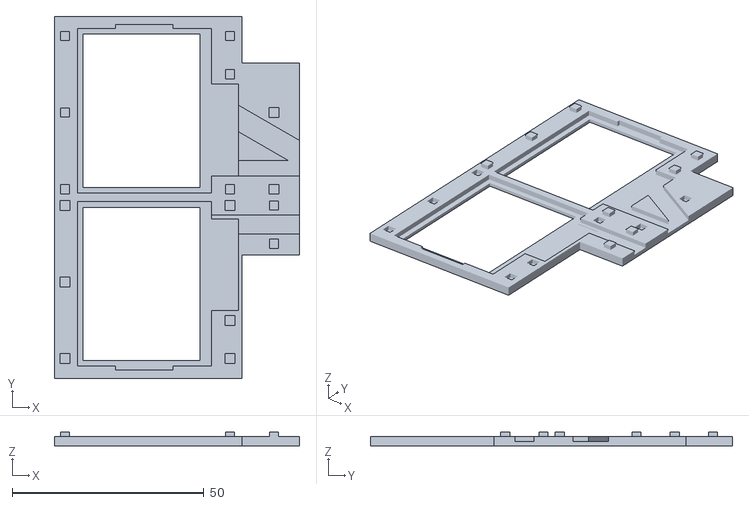
[picture p36: CAD file, 2020-05-22]
openSCAD/transceiver_block_video_shutter_a.stl
64.0 x 94.5 x 3.70
