RensBloom/LuxSenz/openSCAD/transmitter_cap.stl

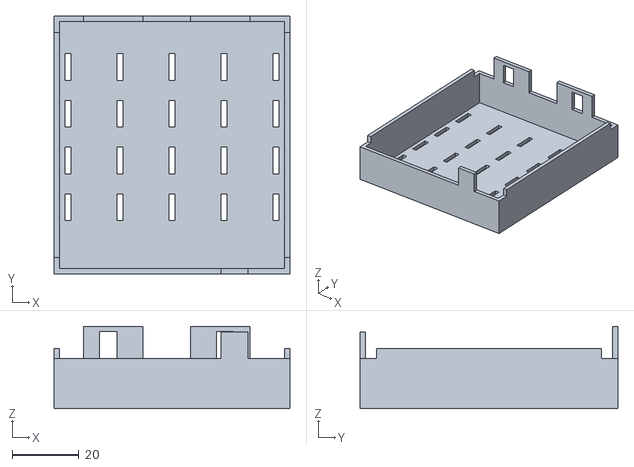
[picture p37: CAD file, 2020-05-22]
openSCAD/transmitter_cap.stl
70.6 x 77.3 x 24.7
