RensBloom/LuxSenz/openSCAD/transceiver_block_3d_glass_shutter.stl

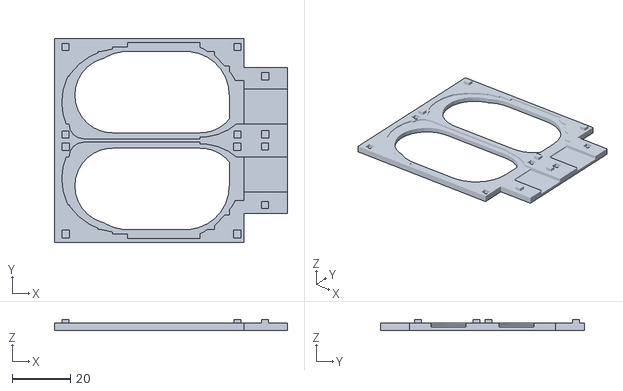
[picture p38: CAD file, 2020-05-22]
openSCAD/transceiver_block_3d_glass_shutter.stl
80.0 x 70.0 x 3.70
