RensBloom/LuxSenz/openSCAD/receiver_case.stl

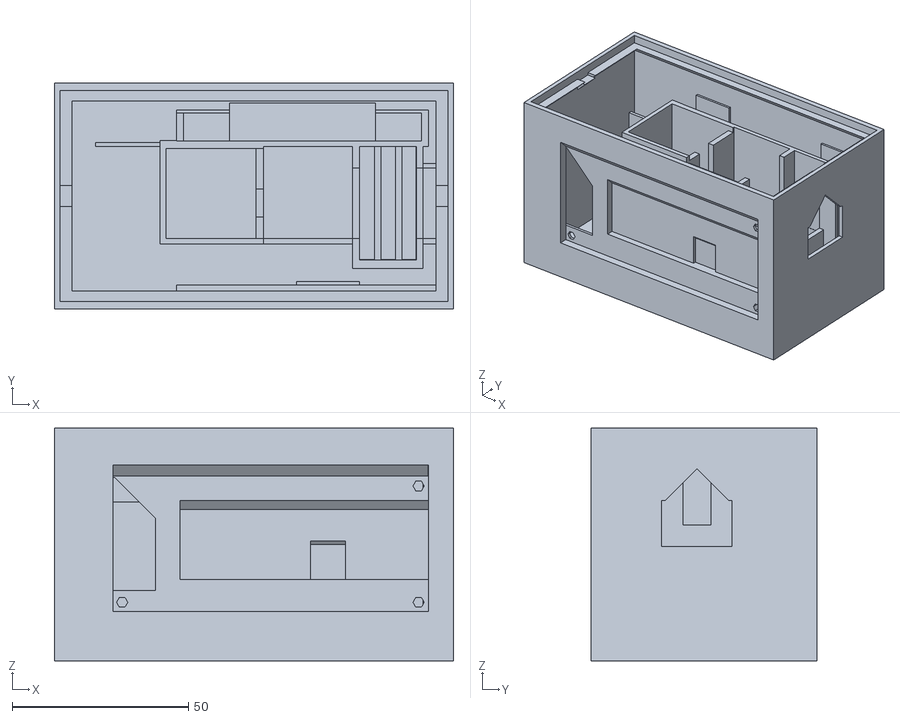
[picture p39: CAD file, 2020-05-22]
openSCAD/receiver_case.stl
113.2 x 64.0 x 66.0
