RensBloom/LuxSenz/(list of files, cad)

Other CAD files:
openSCAD/transceiver_block_video_shutter_b.stl
openSCAD/transceiver_case.stl
openSCAD/transceiver_block_video_shutter_b.scad
openSCAD/transceiver_case.scad
openSCAD/transmitter_block_3d_glass_shutter.scad
openSCAD/transmitter_block_video_shutter.scad
