RensBloom/LuxSenz/documentation/LuxSenz assembled circuits 20181227.pdf

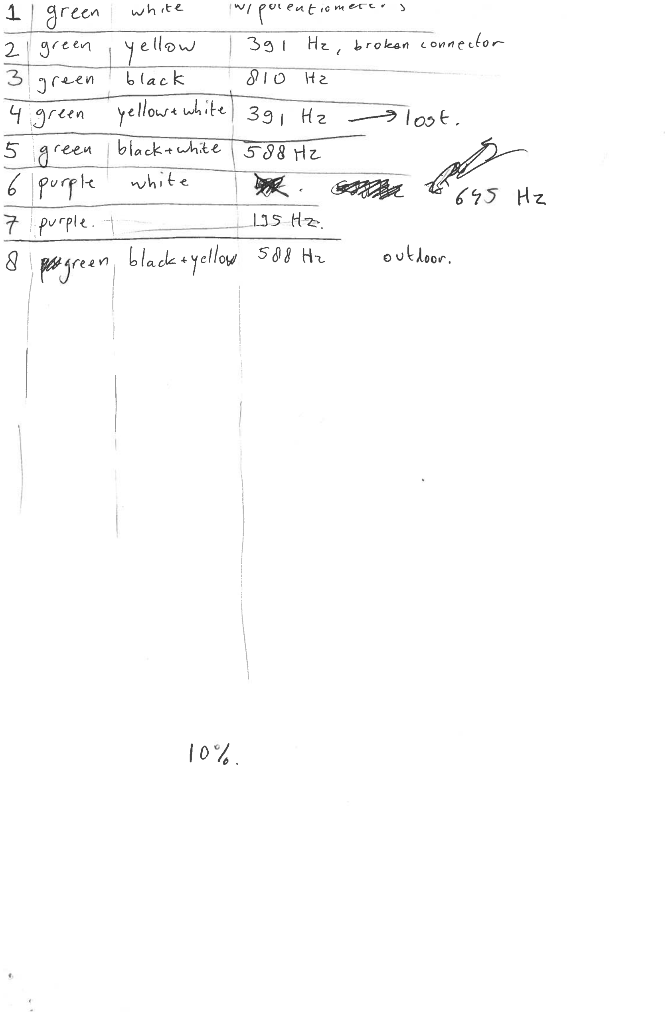
[picture p68: page 1]

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
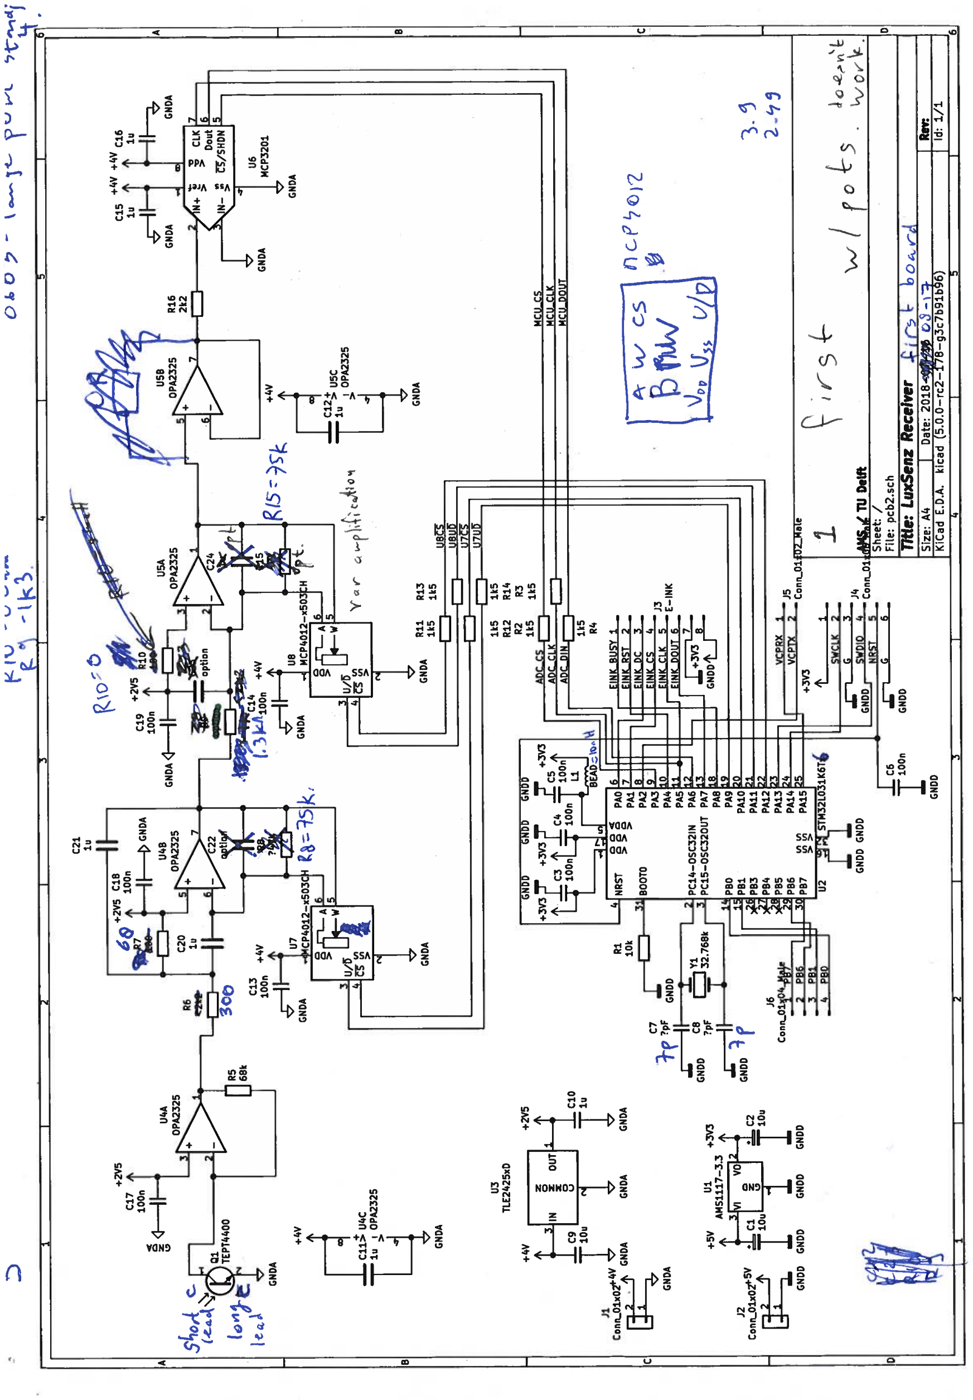
[picture p69: page 2]

# Ck09 - j.1’L_

C21
lu

+2V5 +2115 C18

## lOOn

# iOOfl _GNDA

# U4A U4B

# 0PA2325 0PA2325

+ C20 +

01 —

lu

— C22

TEPT4400

# 3ce U

85

# 68k C13 +4V lOOn ON DA

# +4V GNOA CP4012—x5O3C 95 0—

# 14A __

w

# I C11 U4C 4

>

# lu I [,OPA2325

# GNOA

# GNDA

1k5

812
82

# 1k5 ADC Cs

# ADC C K

# rcOlN

# KINK_BUSY 1

1 j

# EINK_RST 2

# I EINX_DC 3 I EINK_CS 4

# I EINK_CLK 5 —

# I! EINK_DOUT 6 — K—INK

_

_

r

ON 00

# PBO — —

P81 — —

P83 — —

# PB4 . .-.__ —

# PB5 PAI3 VCPRX 1

# PBS PAI4 VCPTX 2

# PB7 fr45 Conn_O1 ÷3113

1

# U2 fTM32031(6T

# SWCLK 2

G 3

# SWDIO 4 GNDD GNDD GNDD i NPST Ccnn_0

7 3 I 4 I 5

C19 +2V5

810

U5A

C15 ÷4’1 ÷411

GN DA

# lOOn

j A2325 -

2k2

# CLK[_

# GNDA—fl

# : __23 816 ONDA —

# > 5 IN— CS/SHON

‘cL

U6

# .I’in ÷4V ONDA

# 1MCP3201

U8

1;5Op4.

÷4V

Cili

# Ic! GNDA

u/5

# I GNDA

# Ci2 U5C

I 0P42325

I

r’

# GNOA 811 813 ONDA

# 1k5 ikS

U8

# UBU5

U7

U7U5

1k5

814
83

1k5

U3

# TL.E2425xD

# CDnn1xOzI-5v

1-i.

# GNDD

# ONOD GNDD GNDD

# I3y3 ÷3V3 +3113

# 1C3 ICIt 0fl

# OOflL1

# BEADlc,•’

# 81 L_4 < NRST oo PAO

10k > > PAl z._jj_.

# C7 _[—CE]—-—-— 800T0 PA2 u—f-f-f—i

# PA32HII ?pF ONDO PA4

# II PCI4—OSC32IN

PA5

# PA6 GNDD CS

# ?pF 32.768k PC15OSC32OUT PA7

PA8—

PAD

# GNDO PAID

PAll

# is II Con

# 2 PBS

3 P81

4 P80

# +5V Ui +3V3

# A AMS1117—3.3

# Lci[] jC2

I

# lOu 100

# GNDD GNDD GNDD

MCII cc MCIi CIK

## ri fl C- P’7 0) Z

## U_.MaIC

I

# rAM$, 1U DeLft

±C6

## lOOn

# GNDD

6

# GNDD

_,.‘3

# / r ° .f cv

# Sheet: / File: pcb2.sch

# Title: LuxSenz Receiver 4 - Io

# Size: A4 Date: 20184 (3 I Rev: -

# I 1 I I

KiCad E.D.A. Kicad b.U.U—rcI—1Id—g.cIb91D9b) I Id: 1/1.

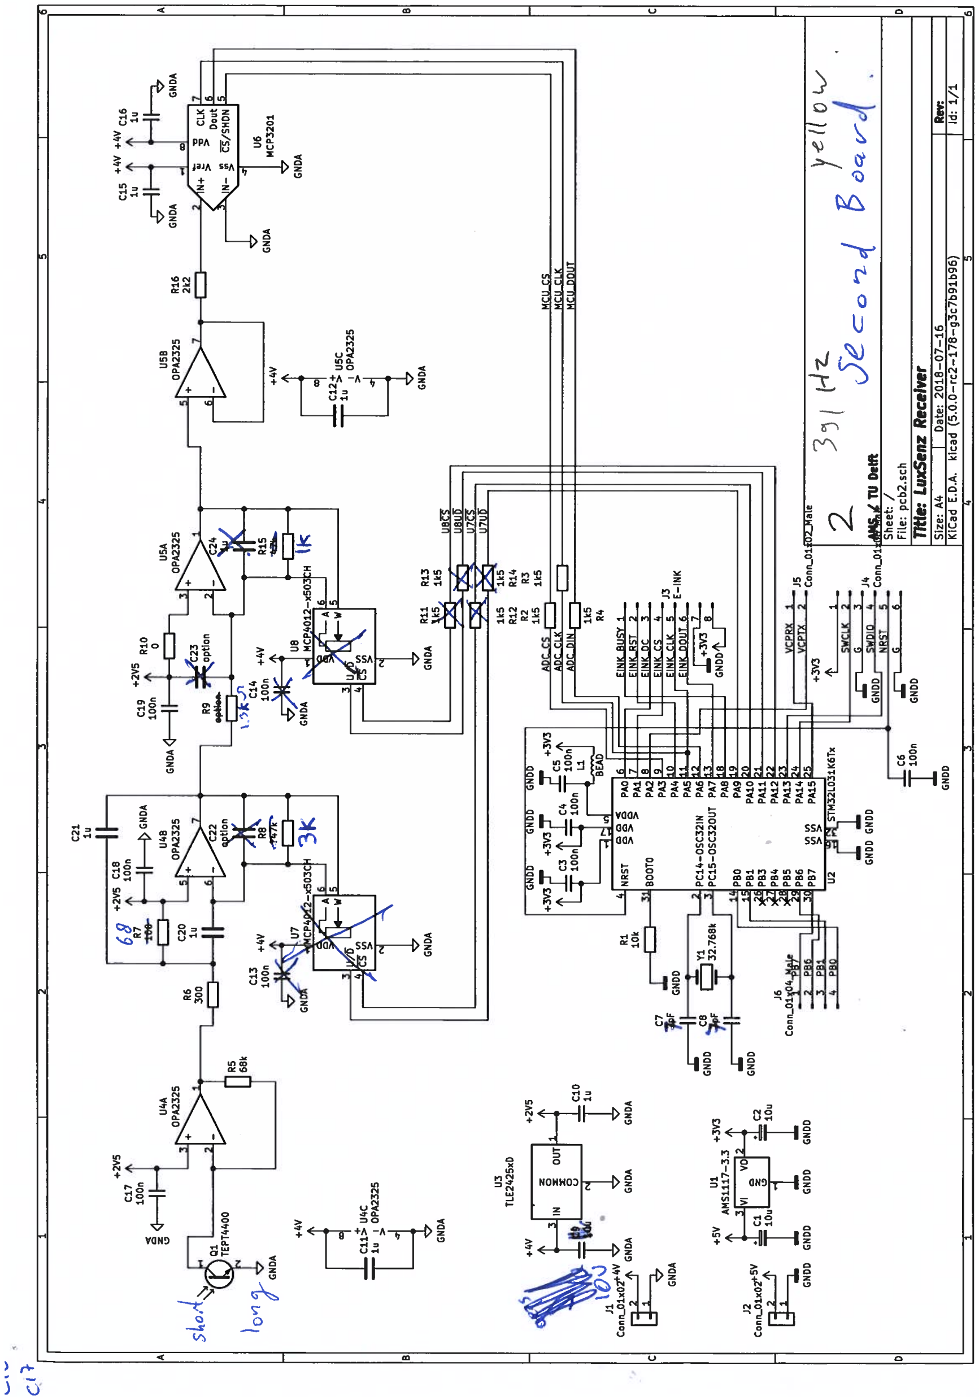
[picture p70: page 3]

# 1 I 4 4 I I 6

.i-2V5

C21

RiO

U5A

0PA2325

÷4V

# C1i U4C GNDA

U5B

# 0PA2325 R16

# C15 +4V ÷4V C16

# GNDA

U3

# TLE2425xD

11C12 +

# 1OPA2325

G N DA

# GNDA

Ri

10k

# connixoz5V

I

# GNDD

# ÷5V Ui +3V3 AMS1117—3.3

# 3vi vo2 GNDD

# GNDD GNDD GNDD JO

# Con n_0i +3V3

1

# SWCLK 2

G

# SWOIO !JaP_i NRST 5 Conn_01

# GNDD I0n

# GNDD

## UL.j9d10

2

I

# EC)2d

# AJ4$,(TUDeIft I

# Sheet: / File: pcb2.sch

# Title: LuxSenz Receiver

Size: A4 I Date: 2018—07—16 Rev KiCad E.D.A. kicad (5.0.0—rc2—178—g3c7b91b96) Ia: 1/2.

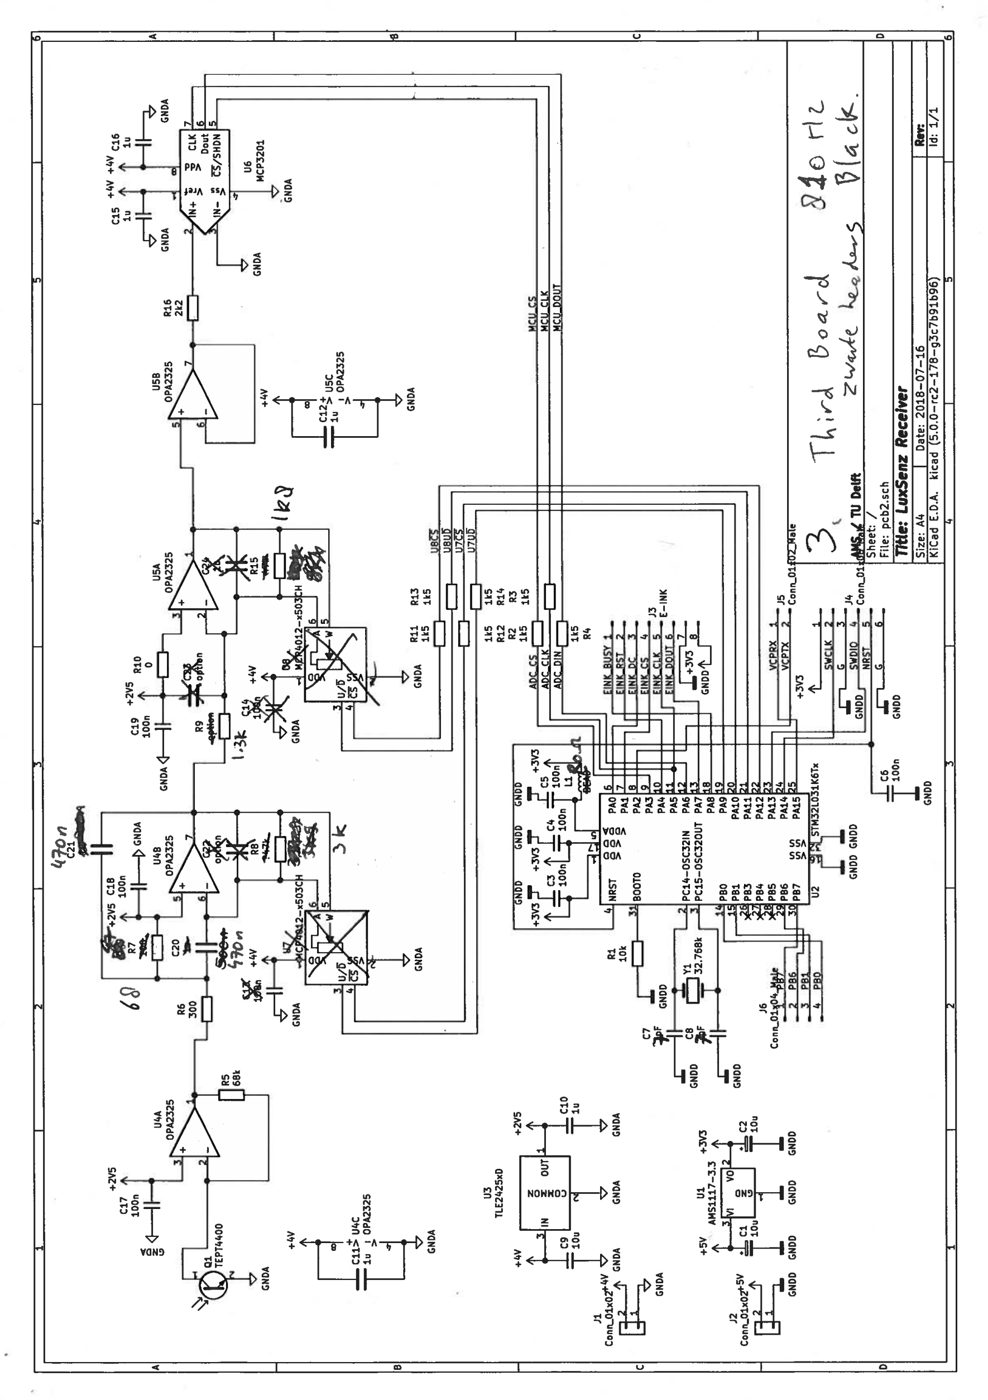
[picture p71: page 4]

# 7 3 I 4 I I 0

÷4V

# _l_ C11

# iOPA2325

# ON DA

# C19 +2V5 Rio lOOn 0

0PA2326

R9

# L__

14 +4v 815

# 012—o5O3 H GNOA

t

4

/4—

813

1k5 —

# UBCS

U8U
U7

U7U5

1k5

P14
R3

1k5 bPIUU bNUU br4L)L,

# +3V3 +3V3 _E +3V3

# NRST PAO

# > PAl

# BOOT0 PA2

PA3

PA4
PA5

PA6

PA7
PAP

# PBO PAS

P81 -

PB3

PB4

# PB5 PA13

# PBS PA14

# P87 PAI5

# U2 _PTM32L031K6Tx

# GNDD GNDD

# ONDO

1k5

R12
82

1k5

# ADC Cs

# ADC CLK

# DcIN

# EINK_BUSY I

BINK

# RST 2

# EINK_DC 3

# EINK_CS 4

# EINK CLI< 5 E—INK EINK_DOUT 6

# GNDD

# VCPTX 2 Con ri_Ol +3V3

# VCPRX 1

# SWCLK 2

_;—l 5 3

# I GNOO i SWDIO 4 Conri_.Ol NRST 5

# GNDD

# +2V5 +2V5 CiB H lOOn C17

# lOOn 619 87 I_____GNDA

U4A 048

# 0PA2325 0PA2325 3 C20 + R6 1 300

01 2_ 6

# TEPT4400

68k

+4V 88

# ONDA

# ONDA .-MC 2—o503C

C 5
w5

3k 4

>

ON DA

03

# TLE2425oD

+4V +4V

_________

CH AtlS

# lu lu

U5B

# 0PA2325 816 GNDA GNDA

+ 2k2

# CLK I7j > > Dout6

# IN— I/SHDN

# 1 +4V ONDA MCP32OI

I7

GN DA

## MCII CC

# Con n_01x0t41’

# [12 GNDA

u1GNOA

ONDA

# GNDA GNOA

# Conn..OixO5’

# GNOO

# +5V Ui +3V3 AMS1117—3.3

# 3vi vo2

# tu I tu

# ONOD GNDD GNDO

Ri -

10k

C7

# pF GNDD

# II ONOD L__

T .768k

# GNDO

# ii J5

# II> Coon_O15044e

# II 2 P86 3

3 P81

4 P80

# MrII re

# PC14—DSC32IN

# PC15—OSC32OUT

# MCLI flOUT

‘—1

## ‘AiI. —

# PAll —

# PAll —

# 0 ...LC6lOOn

# U P a Ic

# A14&I TU Deift b&OV-s c

# Sheet: /

# File: pcb2.sch

# Title: LuxSenz Receiver

# Size: A4 I Date: 2018—07—16 Rev:

# KiCad E.D.A. kiCad (5.0.0—rc2—178—g3c7b91b96) Id: 1/1

2 j I 4

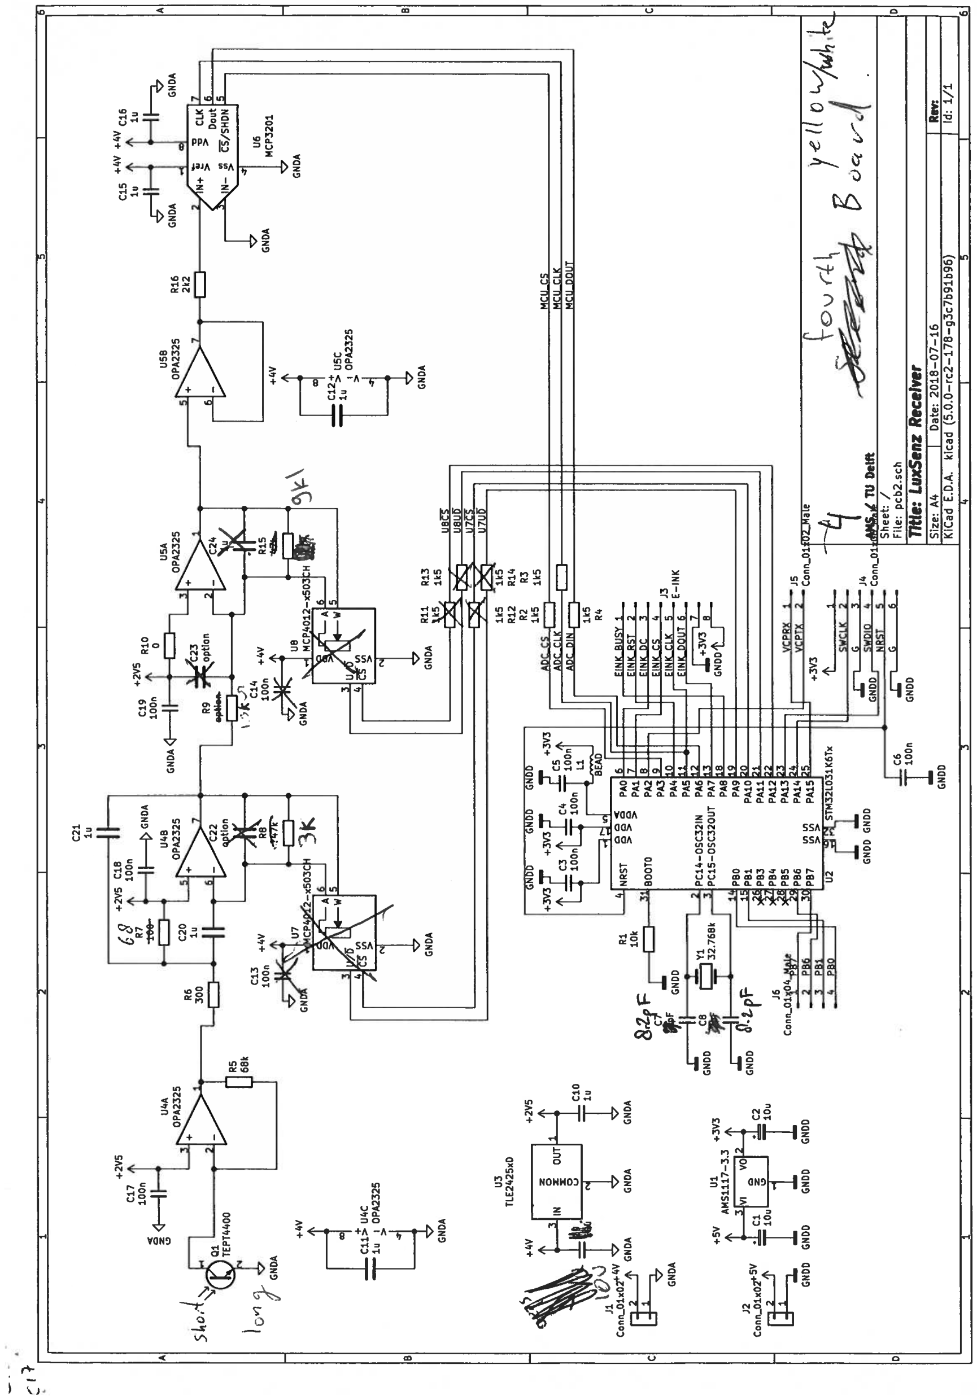
[picture p72: page 5]

# 3 I 4 I 5 I 6

C21
lu

# +2V5 +2V5 C18 H C17 lOOn

# loon 87

U4A

# 0PA2325 0PA2325 C20 + + 86 1U 7 300

01 — — C22

# TEPT4400 tion R5

C13

# ONDA

68k

# ÷4V RB lOOn

# U7 ON I.ICP4 2—x503C

O A6

w

/5 4

>

# ONDA

+ 4V

# C11 U4C

# [1lJOPA2325

# ON DA

# GNDD GNDD GNDD

# +3V3 +3V3 +3V3

# L3 1C4 lOOn

# BEAD

# Ri NRST PAO >> 10k > PAl—JJ—L—— F _L_—cEJ——-l BOOTO PA2

# PA3 2J11 I GNDD PA4 QI_I_t PA5 £ vi L__2 PC14—0SC321N PA6 GNDD 13 — PA8

# 2 768k [—3 PCI5 OSC32OUT PA7

r____i GNDD 2..pF.
J6 >

# Conn_0iRO4...e I PAI3

# 2 PB6 L4l4 PAI4

3 PB1

4 P80

PRO

PBI

P83

P84

P85 4 P86

# P87 u n rA..5 >>

# U2 _[LTM32LO3iK6Tx

# GNDD GNDD

1k5

812
52

# 1k5 ADC Cs

# EINBU5Y 1

# 1EINK_RST

1 2

# EINK_DC 3

# EINK_CS 4

# EINK_CLK 5

# EINK_DOUT 6 E—INK

0500
+3V3

# VCPTX 2

# VCPRX 1

# Con n_C 1

# SWCLK 2

0 3

# SWb04

# NRST Conn_O

6

# GNDD

# +2V5 C19 RIO ICOn

# 0PA2325 GNOA ‘1— I

# R9Ofl4

# C14 +4V lOOn

# GfU8

RIO

# \— MCP4012 x 3H

# 811 R13 GNDA ikS

- U85

U8V
U75

U7U5

814
R3

1k5

+4V +4V

# _________ C1 l6

# lu lu

U5B

# 0PA2325 RiO GNDA GNDA

+ 2k2

# CLK

____

# > > Dout6

# IN— /SHDN

U6

# + 4V ONDA MCP3201

# _L Ci2 U5C

0PA2325

ON CA

U3

# TLE2425xD

I

# c00_oi0ot4V

# GNDA

L’

# GNDA

# ON DA

ClO

# Ilu

ON DA

# +5V UI +3V3 AMS1117—3.3

# 3vi vo2

# itu

# ONDO ONOD ONDD

# Conn_OlxO2SV

# GNDD

# : MCU

# - MCU pOUT

PA1C

# PAil

Pal,

—+

2

E ±C6

## lOOn

# GNDD

# Sheet: / FiLe: pcb2.sch

# O;Le

•r4

‘1 c q -.

# M4&ITUDeIft

# Title: LuxSenz Receiver Size: A4 I Date: 2018—07—16 Rev:

# KiCad E.D.A. kicad (5.0.0—rc2—178—g3c7bglbgS) Id: 1/I

1 4

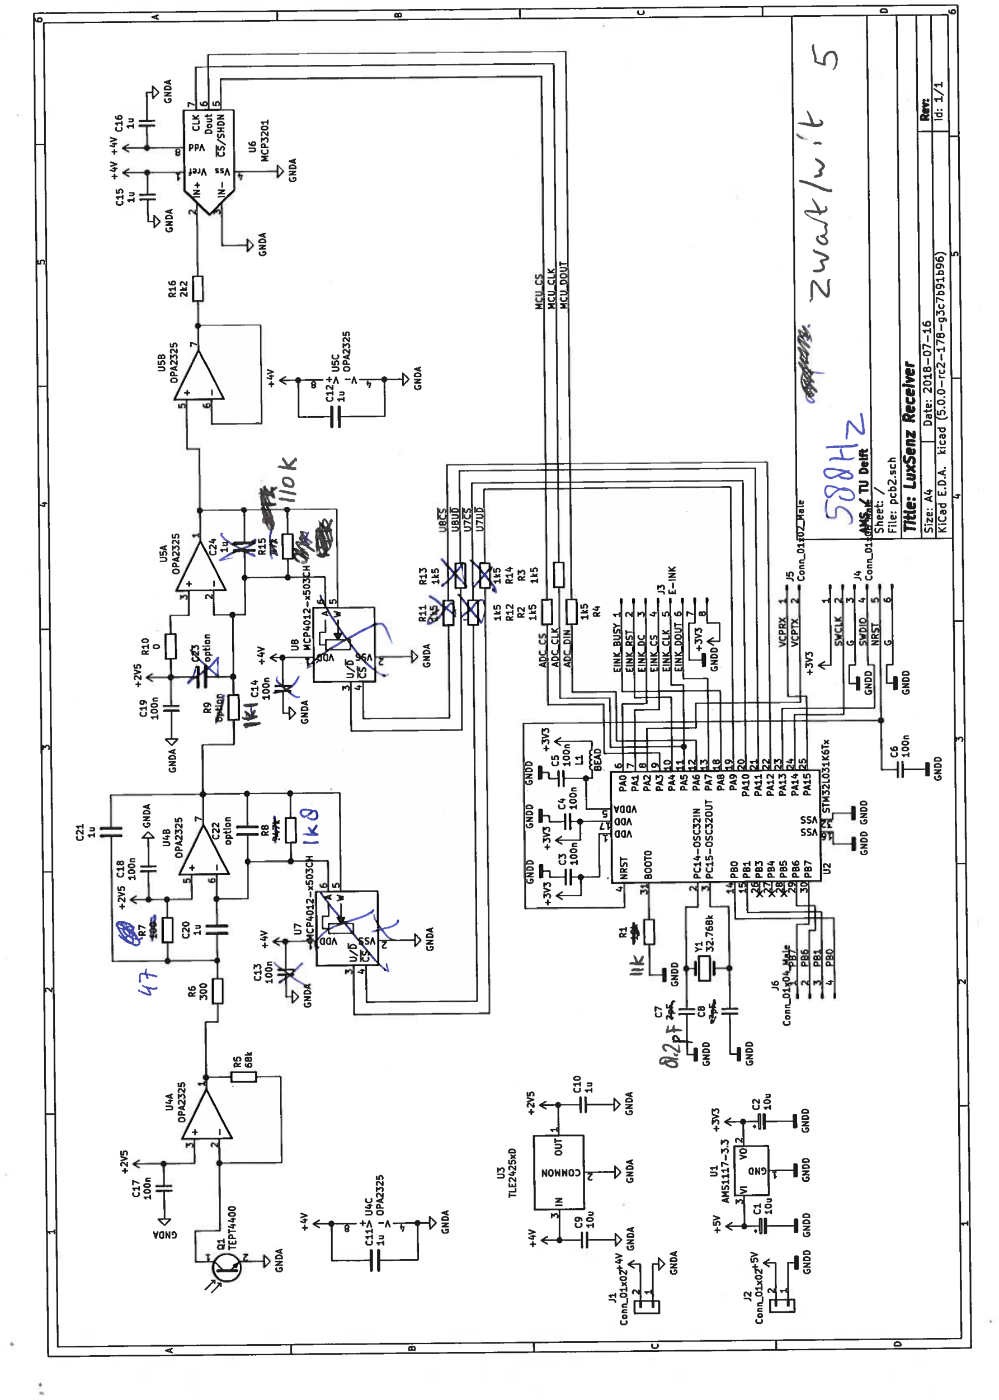
[picture p73: page 6]

# I [—HGND

° I

—n

cc > <

n —

# 4v_vf8i>

cc

n >

N)

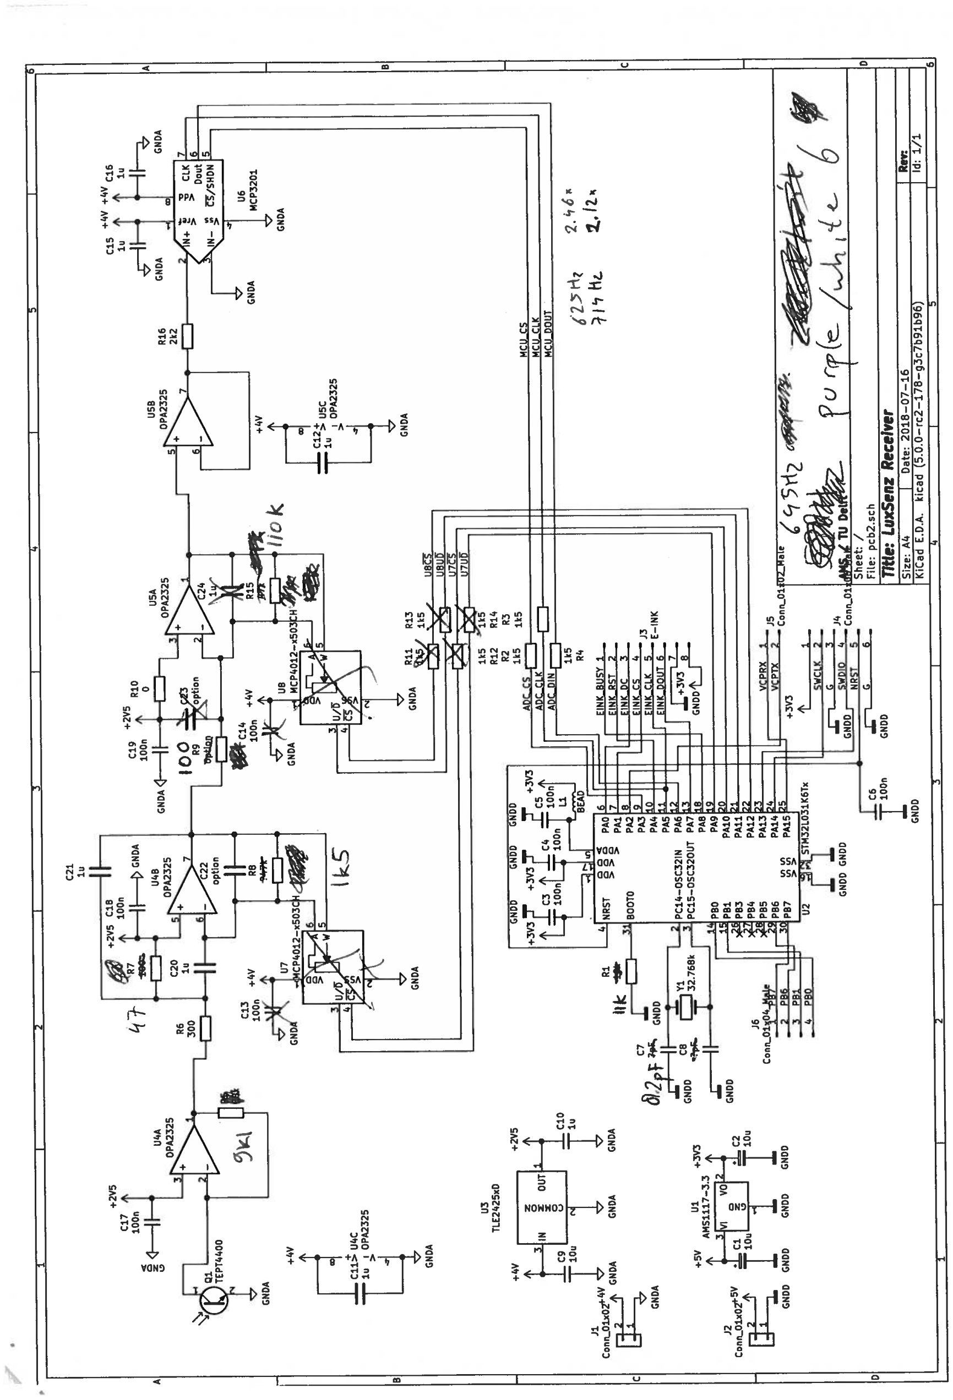
[picture p74: page 7]

# I S I 5 I 6

+3V3

1

# SSICLK 2

3

# SWDIO S

# NRST Conn

# Sheet: /

# _—i C 6 Fite: pcb2.sch

# GNOD

÷2V5

Cl?

# lOOn

C21
lu

USA

0PA2325

GN DA

USA

+4V

# _I_ Cll USC

# _[tOPA2325

## INDA

## Use

C15
‘U

C16
‘U

R16
2k2

# GN DA CN DA

U3

# TLE2S25xD

+4V +2V5

# c0i0O2f5V

# GNDD

# +5V Ui +3V3 AMS1117—3.3

# tULJ

# INDO GNDD GNDD

# GNDD

(2’ r z

.z. ia

J5

# Con n_Il

UI

# GNDD

DeL ?urr(/,u ;‘ ,

# Title: L.uxSenz Receiver Size: A4 Date: 2018—07—16 I RV

—

— I

# KiCad E.D.A. kicad (5.O.O—rc2—176—g3c7b91b96) 1/1

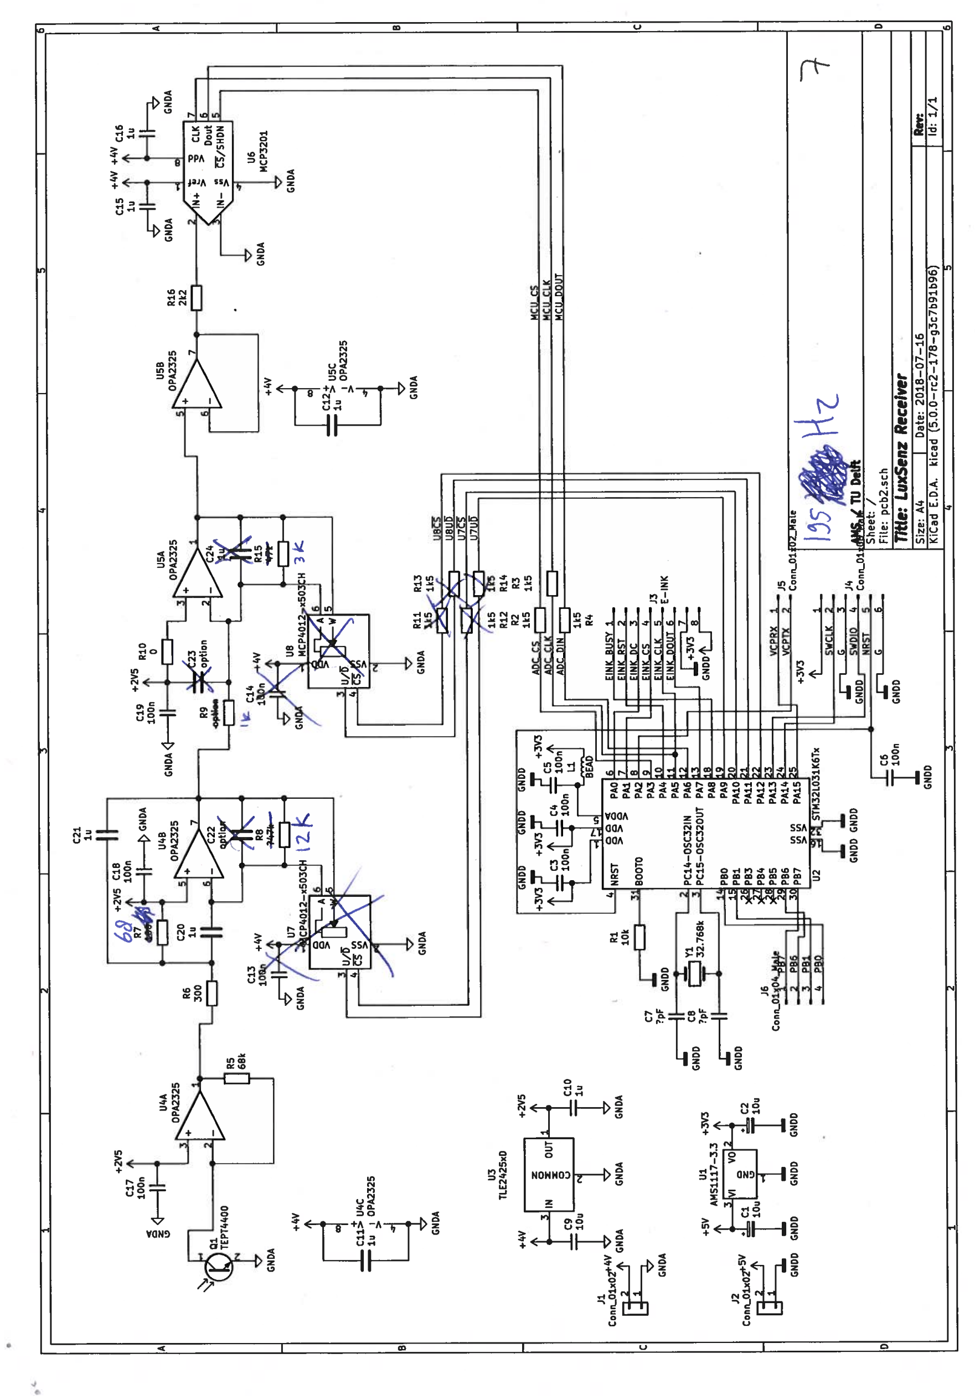
[picture p75: page 8]

# g I I I I

# CONS

# S IS8N CONS 0UUOD +7 DbMS +71 £ 5 L_T

# Z )IiDMS

1 4,

# IQThUO3 e XIdDA Sr —

# 1 X8dDA

# CONS

# 9 lfl0OThINb3 )INH3 )IiDNNI3 £1 SYNNIN

# £ DONNI] —

# 0 LS8NNIN

# I ASflCNNIN

S’II
78

# NIODOV 1=1 Ni) DOV

# SDDOV Sn

£41 Cd

718 0171

# fiflen

# 5Lfl

# flLfl

SB 5 5.2817 -;

# - VONS £18 118

C/fl £

1/

518

# 68 I________

# I I—t’ dO

# 0 0001 018 SAC+ 61)

# 1/I :p (g6q6qLDfl—gLJ—J—oog) pSDi4 903 PDI8

# 9t—L0—9T0 :a;e +y :azi

# .12A,22273 zuasxni ;a

# q3sqDd :apj

/ :;aa745

L

# ian nifl*

24 4E

# CONS

000J CONS CONS

# d(J.9N1OiCCHJ.dI1 £11

## 1JIulJ IIJn

# rn—InK

# 18d £ SIVd L8d

# GOd 17

# 17IVd 98d £ 98d C

# £IVd 58d <

# lIVd +78d

# IIVd £8d <

# DIVd lCd !J CONS

# ICc1 08d II LVd

89d

# ifl000SOSTDd LCCc OoNS 9VcJ NICSDSO—+7TDd

# II 17Vd OONS

# [J116 _____j LD

# OWl 010081

# JzL lCd O1

# OWl woo .LS8N q—b 18 >00

4Y°T
c001 UODm 4, £DT 4,

# _j cAo+I CONS CONS OONS I

# CONS CONS CONS

# I L2_______!lc I

# t—LTIISNV ‘V

# £AO 19 AS

# CONS

4,0

53 11)11

CONS

# SccOvd0 01

O1D

# CONS I

# NOHS/52< __

# 9+7+ TOOCdDII

# CO NS 99

94700<
Ni)

040

p

I

# CONS I CONS 918 SCCCVdO

8511

01 4, 4, 01

91) SI)

CONS

# CONS CONS CONS 4’ 0 L_I

917 400010 0740)

o

rr

## x NI 0

917+ 590+

# ooSa17zfll

£11

CO

# ITt

NO

# SOIZVdO I 01

# D’cfl T1D ]

CONS

£

47

V 0

0

)

# ‘7 j Dcosx—CIO+7dD / VONS Lfl 9+7+

# It4t .. CONS 01 98 - £1) 489

# 58 11 0O1717id3l

# COD — 10

L 971

OOC

# SOCOVdO S000VdO

8+79 9+711

# CONS 4

0001

## SAO

LID

91)

# C I I, I £

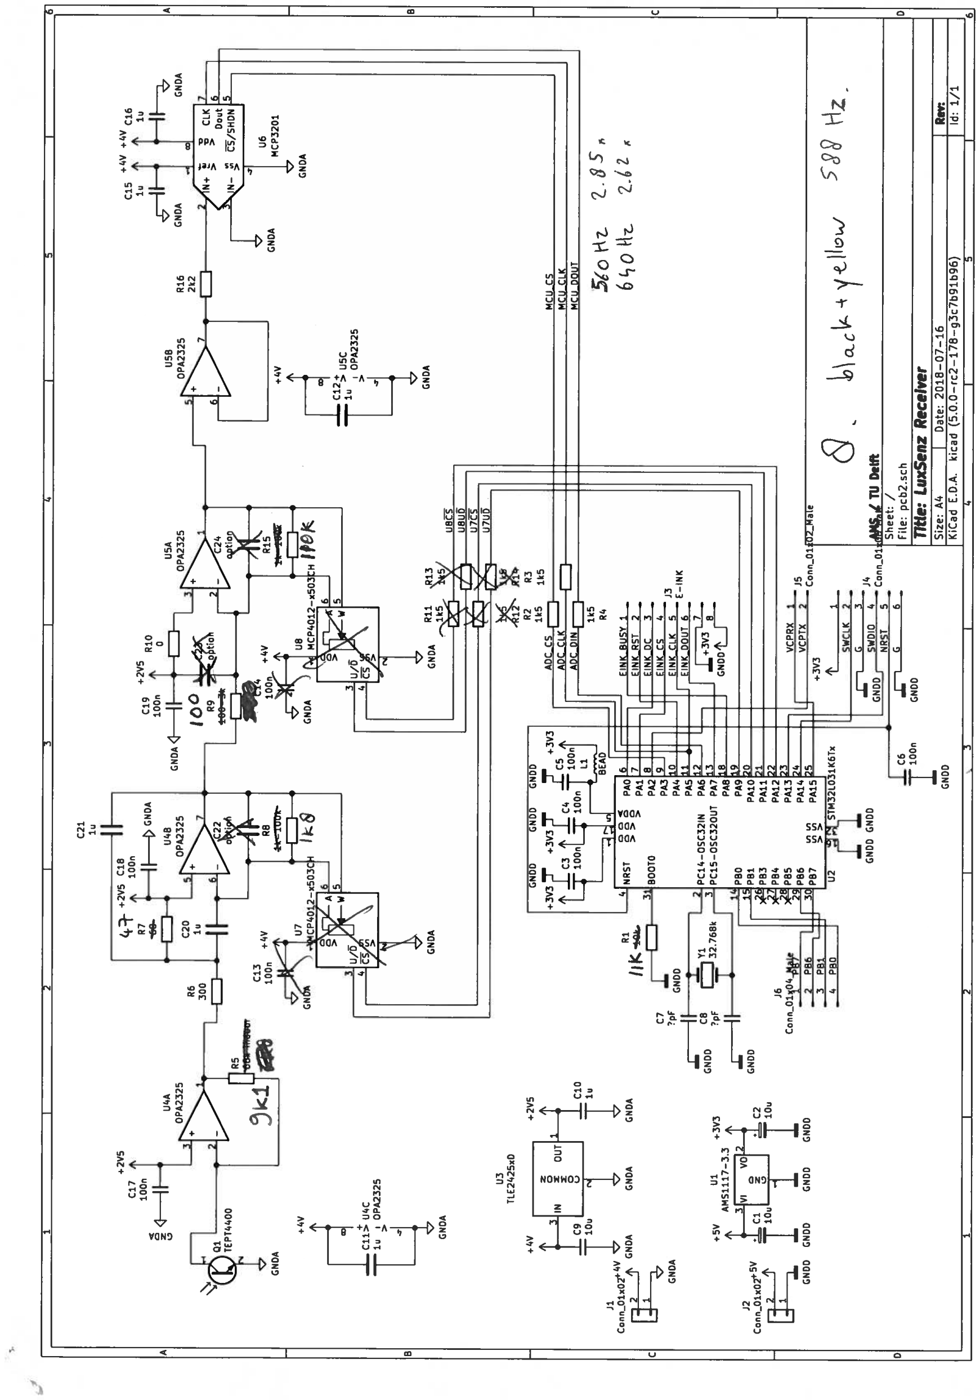
[picture p76: page 9]

# 1 I 2 I 3 4 I I 6

!cl2+

> U5C

# I 0PA2325

# G N IA

A

+2V5

C17

# lOOn

C2 1
lu

U4A

0PA2325

# GNDA

610

USA

B

+4V

# _L-:: .[1OPA2325

# GNDA

# U5B -HI

# IN DA R16

2k2

+4V *4V

# lu lu

# GNOA

13

# TLE2425u0

# ii conn_OlnO244V

2 ‘‘

# GNDA

# ON DA

# ONDA ONDA 61

# IlK --

# ConnlnO2+SV

# GNDD

# *sv Ui *3v3 AMSI117—13

# 3V1 VU2

# GNDD GNDD GNDD

5c z

# 6 o l-tz

?8S
z.z

# GNDD GNDD

J5

# Con n_un +3V3

1

# SWCLK 2

3

# SWDIO 4

# NRST 5 Conn_D1

6

# GNDD

&

# (4W4SOI TU Deift

# GNOO

# Sheet: / File: pcb2.sch

# S’R -z

# KiCad E.DA. kicad (5.0.O—rc2—178—g3c7b91b96)

# Title: LuxSenz Receiver

# Size: A4 Date: 2018—07—16 Ri,:

I

# I I 2 I 3 I 4

Id: 1/1
