RensBloom/LuxSenz/documentation/assembly receiver/double battery 1.jpeg

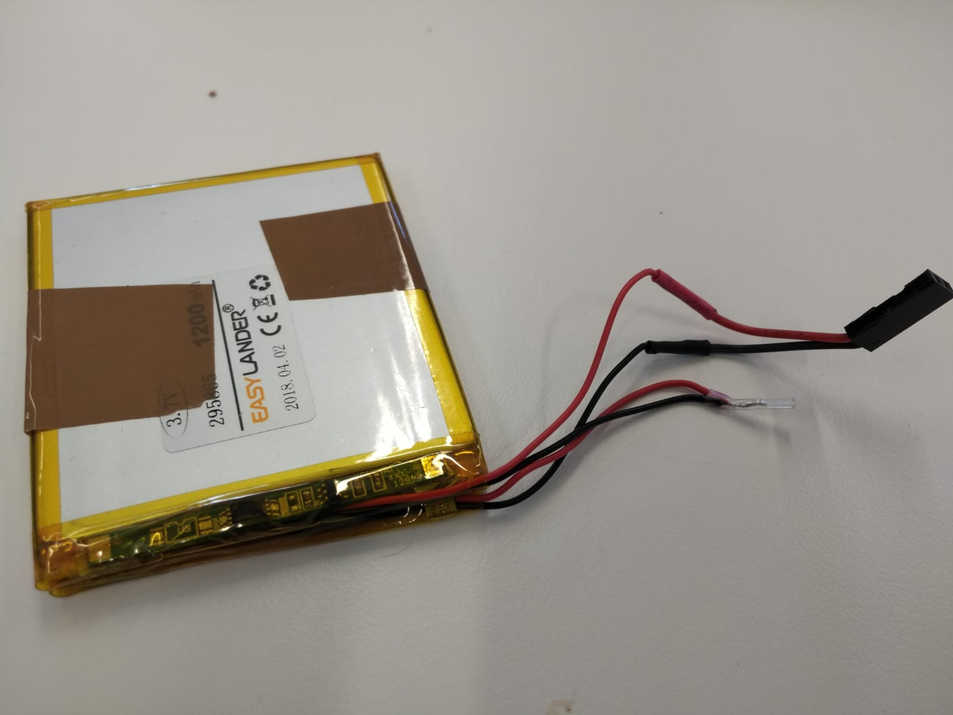
documentation/assembly receiver/double battery 1.jpeg
