RensBloom/LuxSenz/documentation/assembly receiver/double battery 2.jpeg

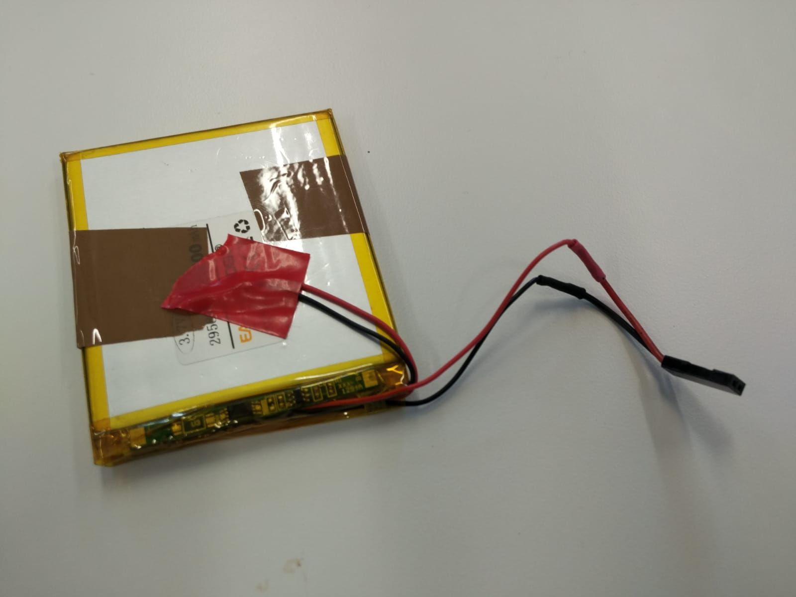
documentation/assembly receiver/double battery 2.jpeg
