RensBloom/LuxSenz/documentation/assembly receiver/eink 3.jpeg

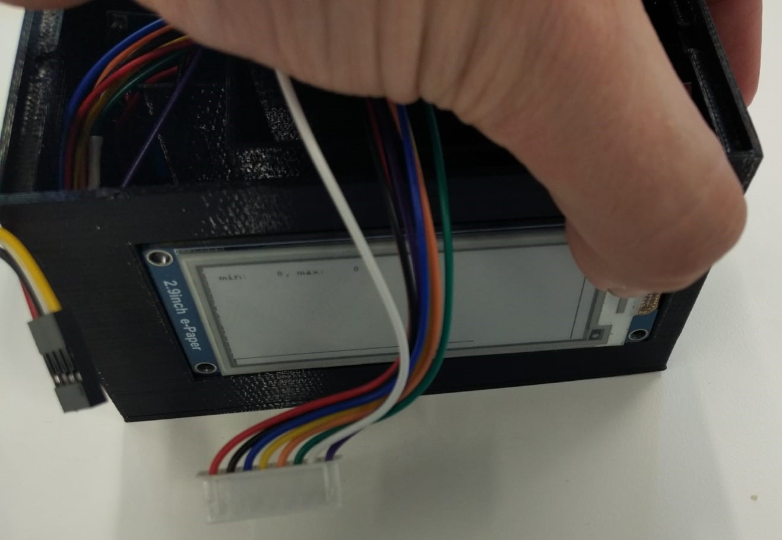
documentation/assembly receiver/eink 3.jpeg
