RensBloom/LuxSenz/documentation/assembly receiver/lens1.jpeg

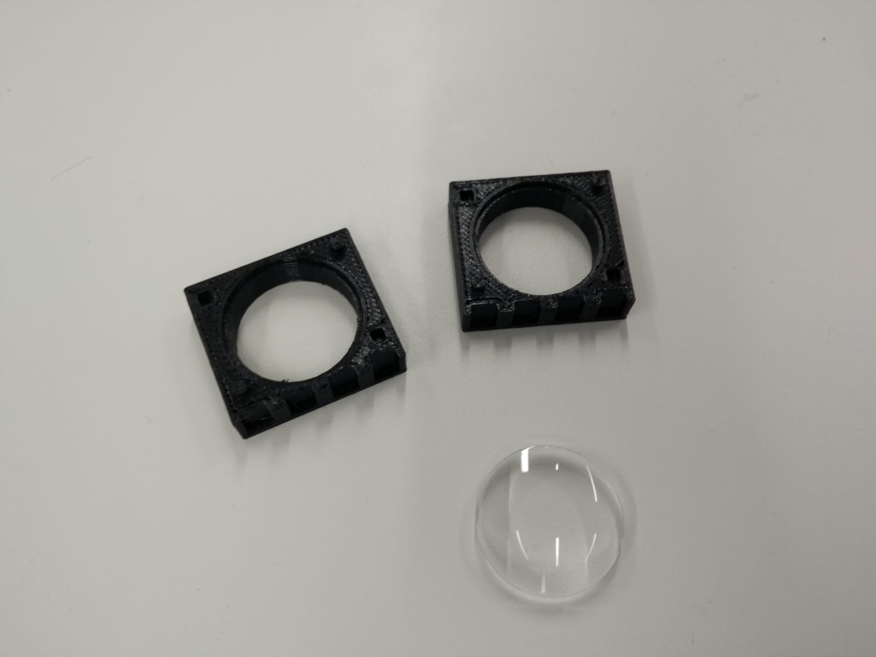
documentation/assembly receiver/lens1.jpeg
