RensBloom/LuxSenz/documentation/assembly receiver/lens4.jpeg

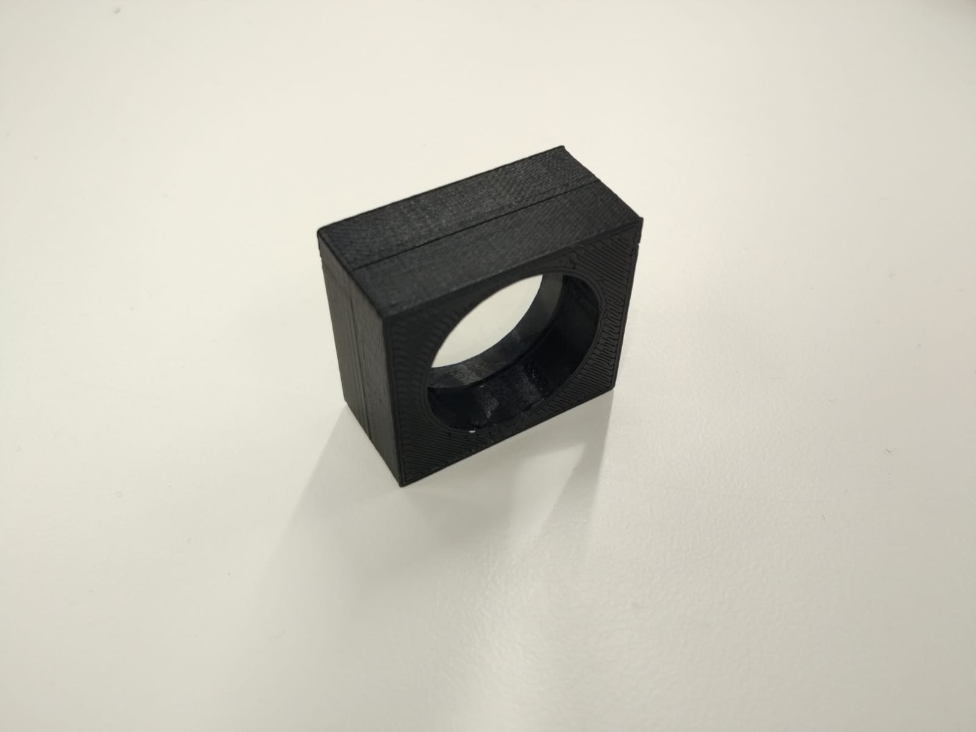
documentation/assembly receiver/lens4.jpeg
