RensBloom/LuxSenz/documentation/assembly receiver/solar panel 1.jpeg

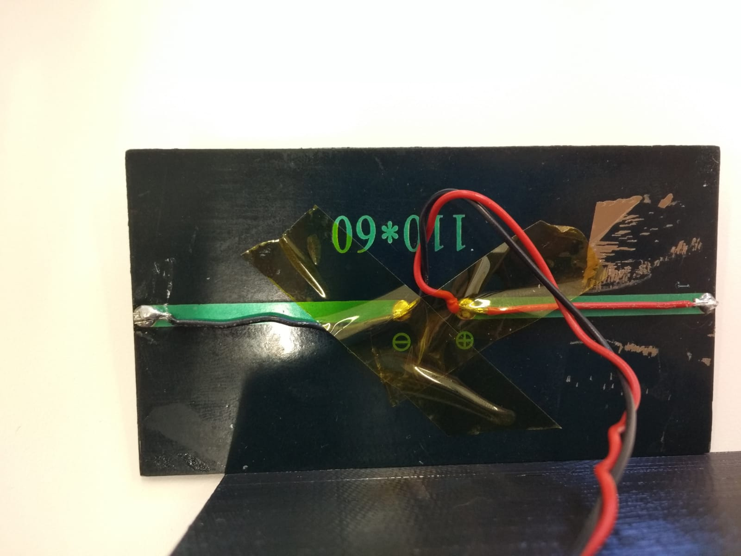
documentation/assembly receiver/solar panel 1.jpeg
