RensBloom/LuxSenz/documentation/LuxSenz receiver schematic.pdf

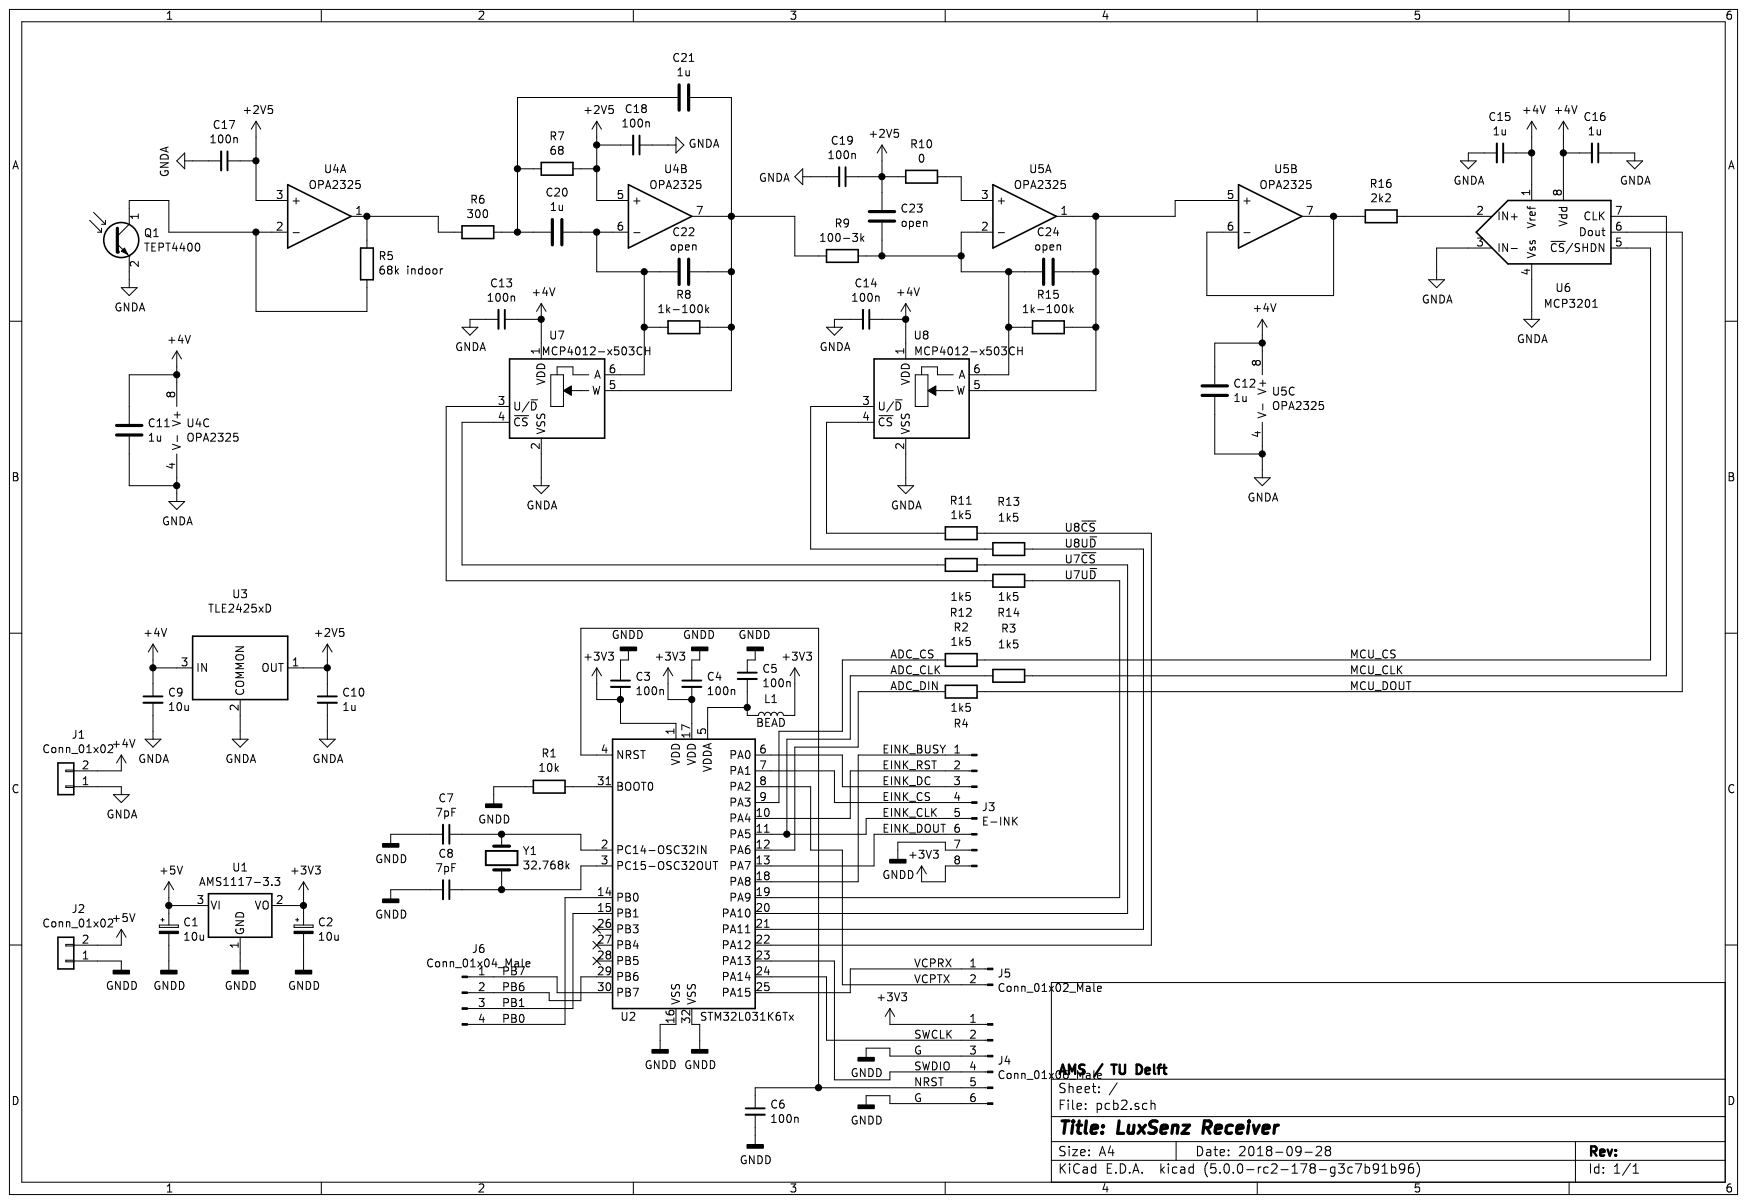
[picture p83: page 1]
