RensBloom/LuxSenz/LTspiceXVII/Draft1.asc

C1: cap; 100n
C2: cap; 100n
C3: cap; 100n
R2: res; 1k
R3: res; 50
R4: res; 20k
R5: res; 100
R6: res; 3k
U1: OP284
U2: OP284
U3: OP284
V1: voltage; 2.5; Rser=0
V2: voltage; 5; Rser=0
V3: voltage; PULSE(2.5 2.52 0 0 0 0.000625 0.00125 300)
Named nets: 0, out
.tran 0 4 0 5u
