RensBloom/LuxSenz/LTspiceXVII/Draft1dc.asc

C1: cap; 100n
C2: cap; 2µ
C3: cap; 1µ
C4: cap; 120p
R2: res; 1k
R3: res; 68
R4: res; 45k
R5: res; 100
R6: res; 3k
U1: OP284
U2: OP284
U3: OP284
V1: voltage; 2.5; Rser=0
V2: voltage; 5; Rser=0
V3: voltage; 3
Named nets: 0, out
.tran 0 4 0 5u
