RensBloom/LuxSenz/KiCad/pcb2/pcb2.kicad_pcb

## KiCad design KiCad/pcb2/pcb2.kicad_pcb (2020-05-22)

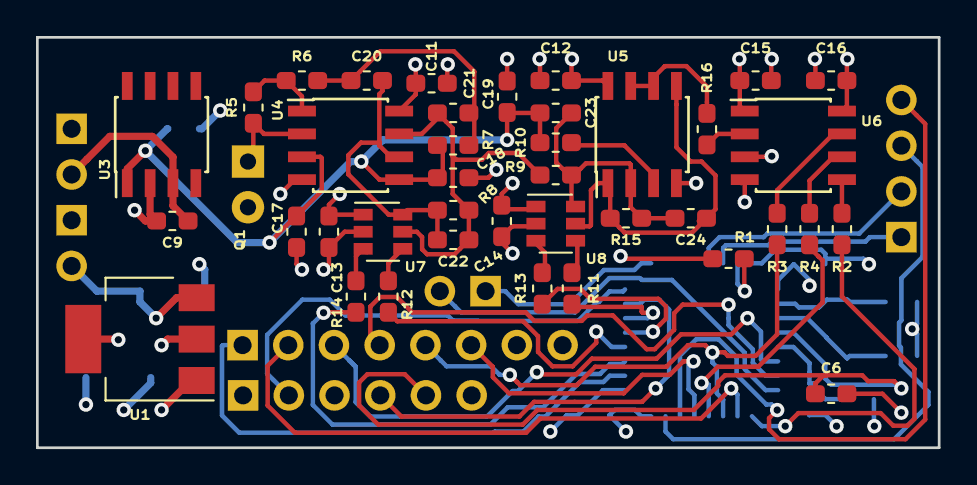
[picture p84: board pcb2.kicad_pcb from above]

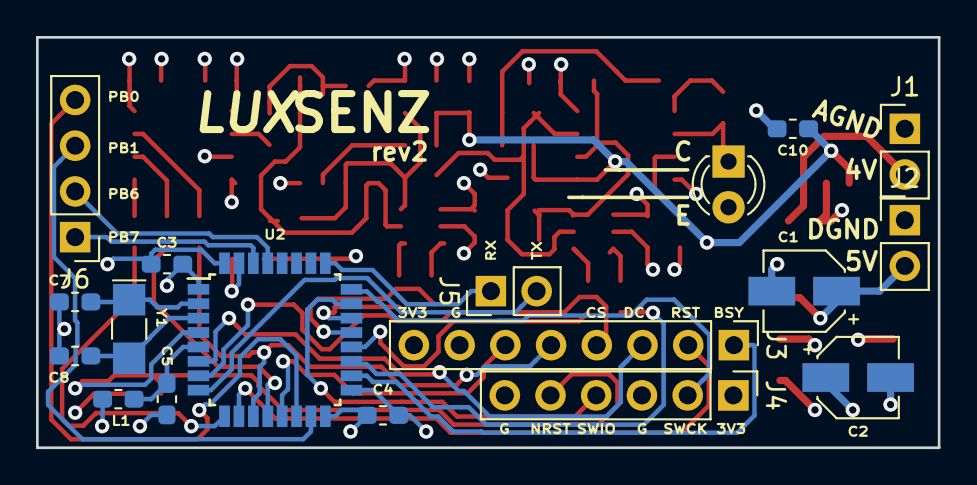
[picture p85: board pcb2.kicad_pcb from below]

Board: 4 copper layers, 50.1 x 22.8 mm, 57 parts (18 on the bottom side), 48 nets.

Parts:
C1, C2: 10u; CP_Elec_4x5.4
C3, C4, C5, C6, C13, C14, C17, C18, C19: 100n; C_0603_1608Metric_Pad1.05x0.95mm_HandSolder
C7, C8: ?pF; C_0603_1608Metric_Pad1.05x0.95mm_HandSolder
C9: 10u; C_0603_1608Metric_Pad1.05x0.95mm_HandSolder
C10, C11, C12, C15, C16, C20, C21: 1u; C_0603_1608Metric_Pad1.05x0.95mm_HandSolder
C22, C23, C24: option; C_0603_1608Metric_Pad1.05x0.95mm_HandSolder
J1, J2: Conn_01x02; PinHeader_1x02_P2.54mm_Vertical
J3: E-INK; PinHeader_1x08_P2.54mm_Vertical
J4: Conn_01x06_Male; PinHeader_1x06_P2.54mm_Vertical
J5: Conn_01x02_Male; PinHeader_1x02_P2.54mm_Vertical
J6: Conn_01x04_Male; PinHeader_1x04_P2.54mm_Vertical
L1: BEAD; L_0603_1608Metric_Pad1.05x0.95mm_HandSolder
Q1: TEPT4400; LED_D3.0mm_Clear
R1: 10k; R_0603_1608Metric_Pad1.05x0.95mm_HandSolder
R2, R3, R4, R11, R12, R13, R14: 1k5; R_0603_1608Metric_Pad1.05x0.95mm_HandSolder
R5: 68k indoor; R_0603_1608Metric_Pad1.05x0.95mm_HandSolder
R6: 300; R_0603_1608Metric_Pad1.05x0.95mm_HandSolder
R7: 68; R_0603_1608Metric_Pad1.05x0.95mm_HandSolder
R8, R15: 1k-100k; R_0603_1608Metric_Pad1.05x0.95mm_HandSolder
R9: 100-3k; R_0603_1608Metric_Pad1.05x0.95mm_HandSolder
R10: 0; R_0603_1608Metric_Pad1.05x0.95mm_HandSolder
R16: 2k2; R_0603_1608Metric_Pad1.05x0.95mm_HandSolder
U1: AMS1117-3.3; SOT-223-3_TabPin2
U2: STM32L031K6Tx; LQFP-32_7x7mm_P0.8mm
U3: TLE2425xD; SOIC-8_3.9x4.9mm_P1.27mm
U4, U5: OPA2325; SOIC-8_3.9x4.9mm_P1.27mm
U6: MCP3201; SOIC-8_3.9x4.9mm_P1.27mm
U7, U8: MCP4012-x503CH; SOT-23-6
Y1: 32.768k; Crystal_SMD_G8-2Pin_3.2x1.5mm_HandSoldering

Connections:
+2V5: C10.1, C17.1, C18.2, C19.1, C23.2, R7.1, R10.2, U3.1, U4.3, U4.5
+3V3: C2.1, C3.2, C4.2, J3.8, J4.1, L1.2, U1.2, U2.1, U2.17
+4V: C9.1, C11.1, C12.1, C13.1, C14.1, C15.1, C16.2, J1.2, U3.3, U4.8, U5.8, U6.1, U6.8, U7.1, U8.1
+5V: C1.1, J2.2, U1.3
/ADC_CLK: J3.5, R3.2, U2.11
/ADC_CS: R2.2, U2.9
/ADC_DIN: R4.2, U2.12
/EINK_BUSY: J3.1, U2.18
/EINK_CS: J3.4, U2.7
/EINK_DC: J3.3, U2.6
/EINK_DOUT: J3.6, U2.13
/EINK_RST: J3.2, U2.10
/MCU_CLK: R3.1, U6.7
/MCU_CS: R2.1, U6.5
/MCU_DOUT: R4.1, U6.6
/NRST: C6.1, J4.5, U2.4
/PB0: J6.4, U2.14
/PB1: J6.3, U2.15
/PB6: J6.2, U2.29
/PB7: J6.1, U2.30
/SWCLK: J4.2, U2.24
/SWDIO: J4.4, U2.23
/U7U~D: R14.1, U2.19
/U7~CS: R12.1, U2.20
/U8U~D: R13.1, U2.21
/U8~CS: R11.1, U2.22
/VCPRX: J5.1, U2.25
/VCPTX: J5.2, U2.8
GNDA: C9.2, C10.2, C11.2, C12.2, C13.2, C14.2, C15.2, C16.1, C17.2, C18.1, C19.2, J1.1, Q1.2, U3.2, U4.4, U5.4, U6.3, U6.4, U7.2, U8.2
GNDD: C1.2, C2.2, C3.1, C4.1, C5.1, C6.2, C7.2, C8.2, J2.1, J3.7, J4.3, J4.6, R1.1, U1.1, U2.16, U2.32
unnamed: C5.2, L1.1, U2.5
unnamed: C7.1, U2.2, Y1.1
unnamed: C8.1, U2.3, Y1.2
unnamed: C20.1, C22.2, R8.2, U4.6, U7.6
unnamed: C20.2, C21.2, R6.1, R7.2
unnamed: C21.1, C22.1, R8.1, R9.2, U4.7, U7.5
unnamed: C23.1, C24.2, R9.1, R15.2, U5.2, U8.6
unnamed: C24.1, R15.1, U5.1, U5.5, U8.5
unnamed: Q1.1, R5.1, U4.2
unnamed: R1.2, U2.31
unnamed: R5.2, R6.2, U4.1
unnamed: R10.1, U5.3
unnamed: R11.2, U8.4
unnamed: R12.2, U7.4
unnamed: R13.2, U8.3
unnamed: R14.2, U7.3
unnamed: R16.1, U6.2
unnamed: R16.2, U5.6, U5.7
