RensBloom/LuxSenz/KiCad/pcb3/pcb3.kicad_pcb

## KiCad design KiCad/pcb3/pcb3.kicad_pcb (2020-05-22)

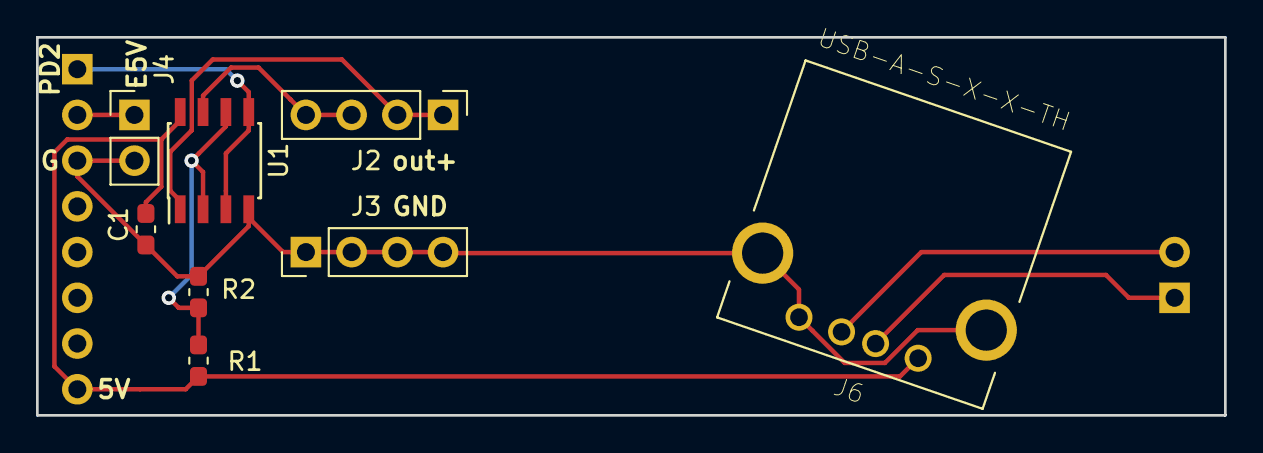
[picture p86: board pcb3.kicad_pcb from above]

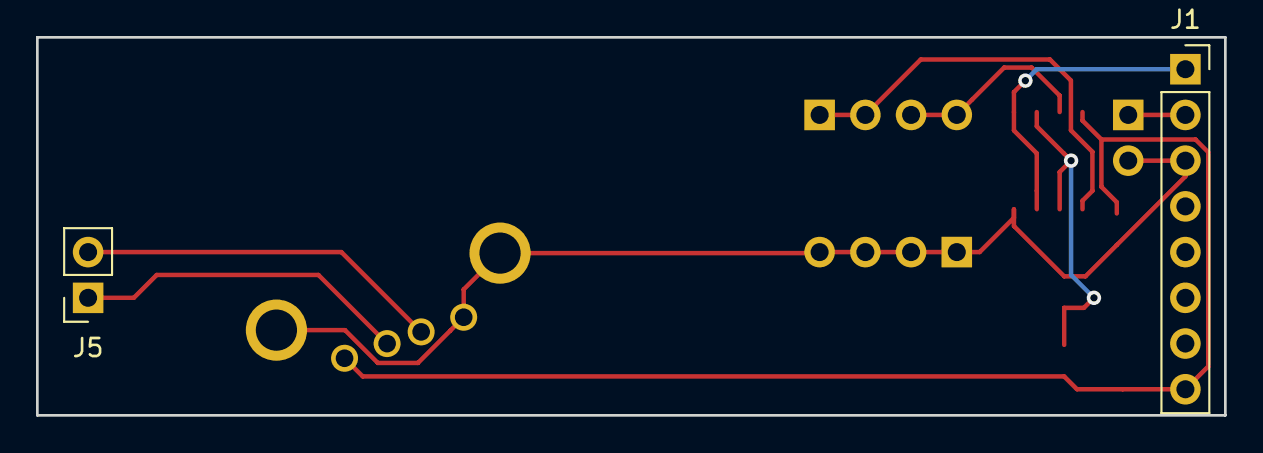
[picture p87: board pcb3.kicad_pcb from below]

Board: 2 copper layers, 66.0 x 21.0 mm, 10 parts (2 on the bottom side), 9 nets.

Parts:
C1: 1u; C_0603_1608Metric_Pad1.05x0.95mm_HandSolder
J1: Conn_01x08_Female; PinSocket_1x08_P2.54mm_Vertical
J2, J3: Conn_01x04_Female; PinHeader_1x04_P2.54mm_Vertical
J4: Conn_01x02_Male; PinHeader_1x02_P2.54mm_Vertical
J5: Conn_01x02_Female; PinSocket_1x02_P2.54mm_Vertical
J6: USB-A-S-X-X-TH
R1, R2: 1k5; R_0603_1608Metric_Pad1.05x0.95mm_HandSolder
U1: OPA2325; SOIC-8_3.9x4.9mm_P1.27mm

Connections:
/5V: C1.1, J1.8, J6.1, R1.2, U1.8
/G: C1.2, J1.3, J3.1, J3.2, J3.3, J3.4, J4.2, J6.4, J6.5, J6.6, R2.2, U1.4
/PD2: J1.1, U1.3, U1.5
/geel: J5.2, J6.3
/wit: J5.1, J6.2
unnamed: J1.2, J4.1
unnamed: J2.1, J2.2, U1.1
unnamed: J2.3, J2.4, U1.7
unnamed: R1.1, R2.1, U1.2, U1.6
