RensBloom/LuxSenz/(notices)

Notices in the files:
BeagleBone/luxsenz/chp13/receive.c:
This program is free software; you can redistribute it and/or modify
the Free Software Foundation; either version 2 of the License, or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
